Phelma-Promo-MT-2026/ZigBee/documentation/design/LNA/LNA_DashBoard_InducDeg.pptx

## LNA DASHBOARD 2.0

## To do list

- Transcient avec bonding → point de compression

## Step 1 - Extraction gm

MOS :
W = 106u
N = 0,130u

Vgs = 0,604V

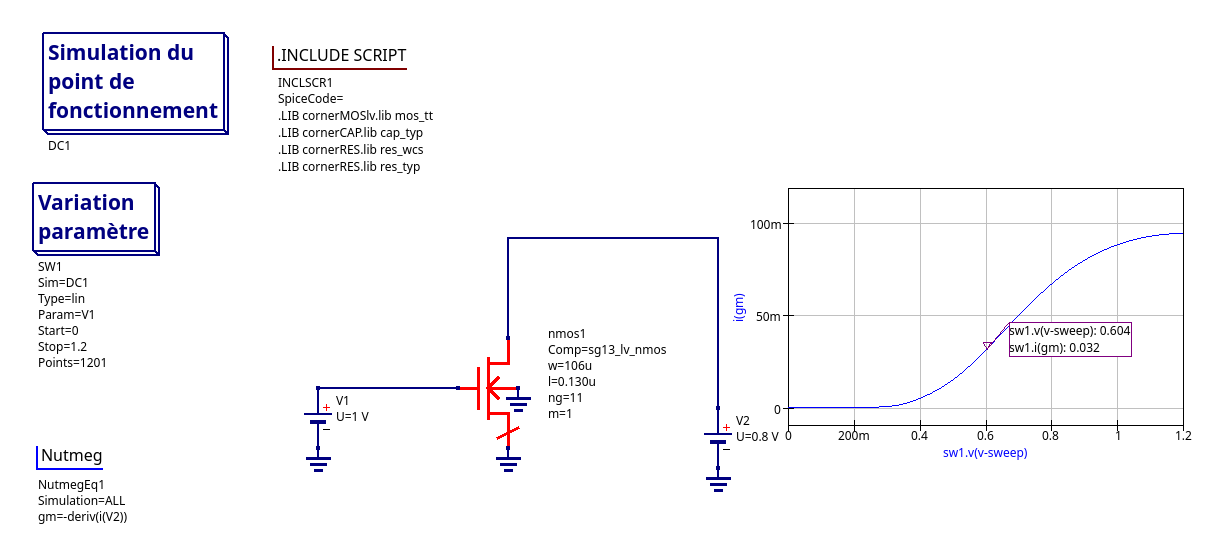
[picture p20: figure]

## Step 2 – Point de polarisation entrée

- MOS :
  - W = 106u
  - N = 0,130u
- Ll = 3nH
- C2 = 700fF
- L1 = 3nH
- Ls = 1,6nH
- Vgs = 0,656V
- Consommation :
- 4,49mA

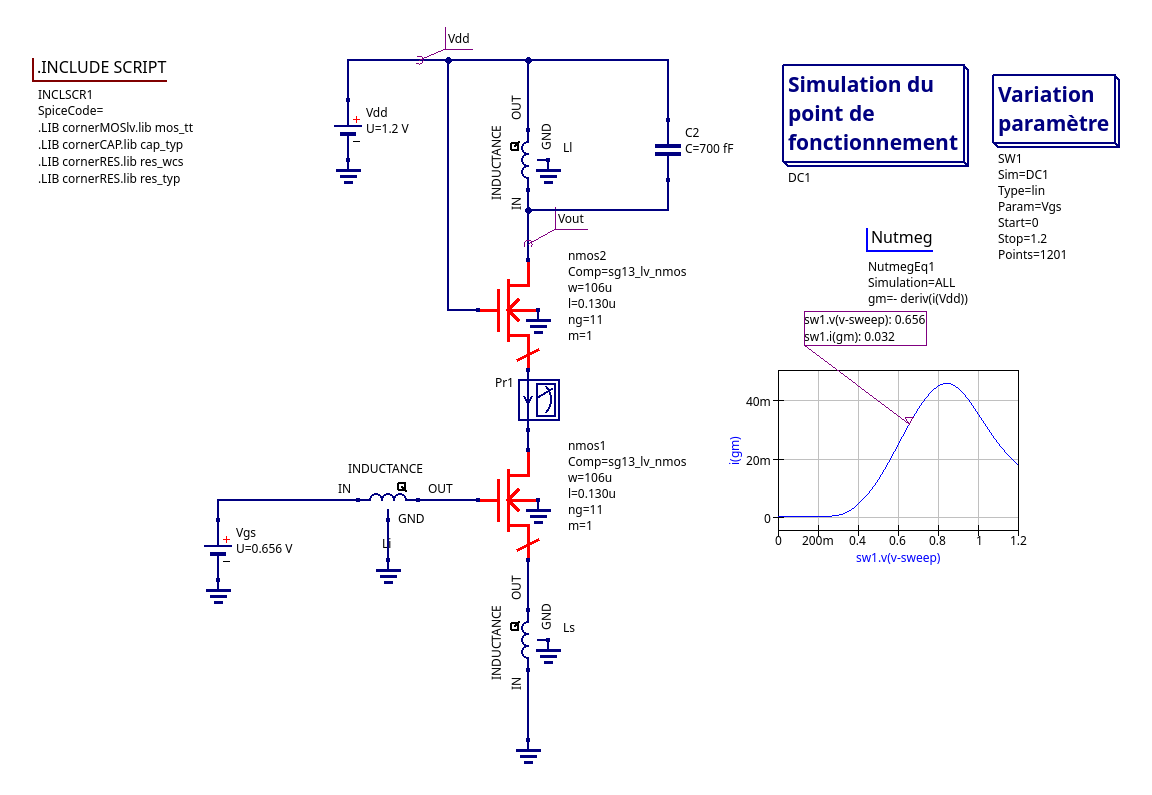
[picture p21: figure]

## Step 3 – adaptation entrée

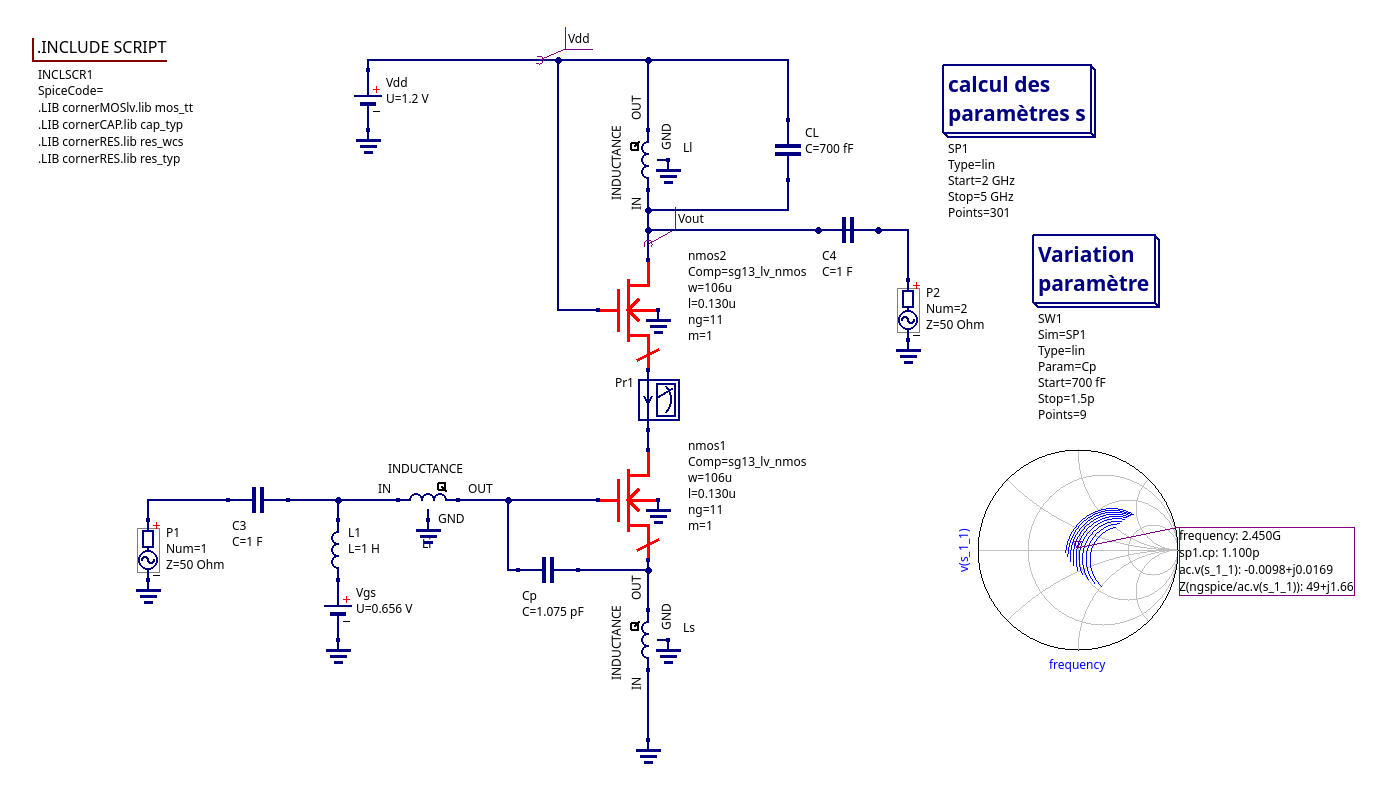
[picture p22: figure]

- Cp=C0=1,075pF
→ W = L = 26,5u

## Step 4 – Mirroir de courant 4.1 – Tune W & L pour 4,49mA dans la branche

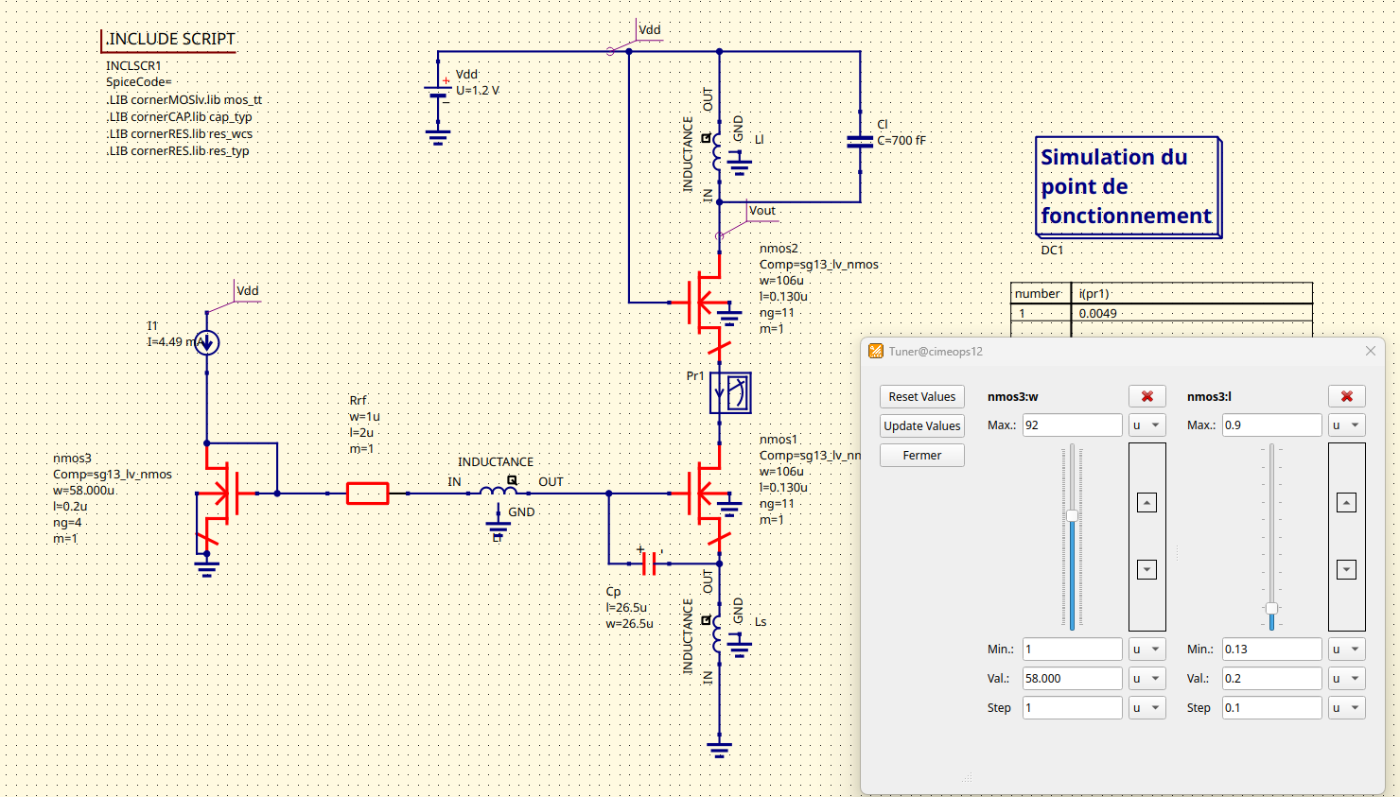
[picture p23: figure]

Rrf sert à empêcher le signal RF de venir sur le miroir
- Rrf = 5k Ohm
  - IHP Rhigh
    - W = 1um
    - L = 2um

NMOS 3
Ngate = 4
W = 58um
L = 200nm

## Step 4 – Mirroir de courant 4.1 – Rpol pour 4,5mA dans la branche

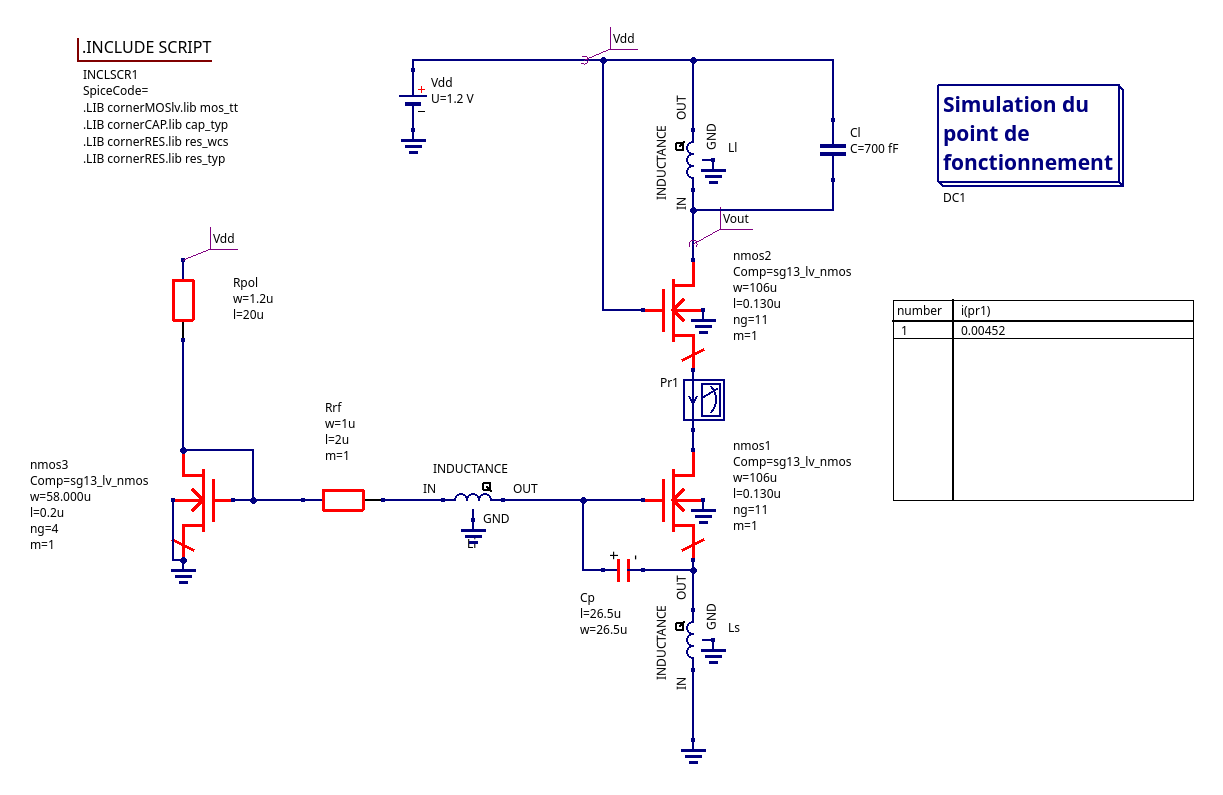
[picture p24: figure]

Rpol sert à polariser le miroir de courant. Par une analyse parametrique sur Rpol, on trouve Rpol = 130 ohm pour I = 4,5mA
En utilisant la resistance Rsil
W = 1,2um
L = 20um

## Step 5 - Gain

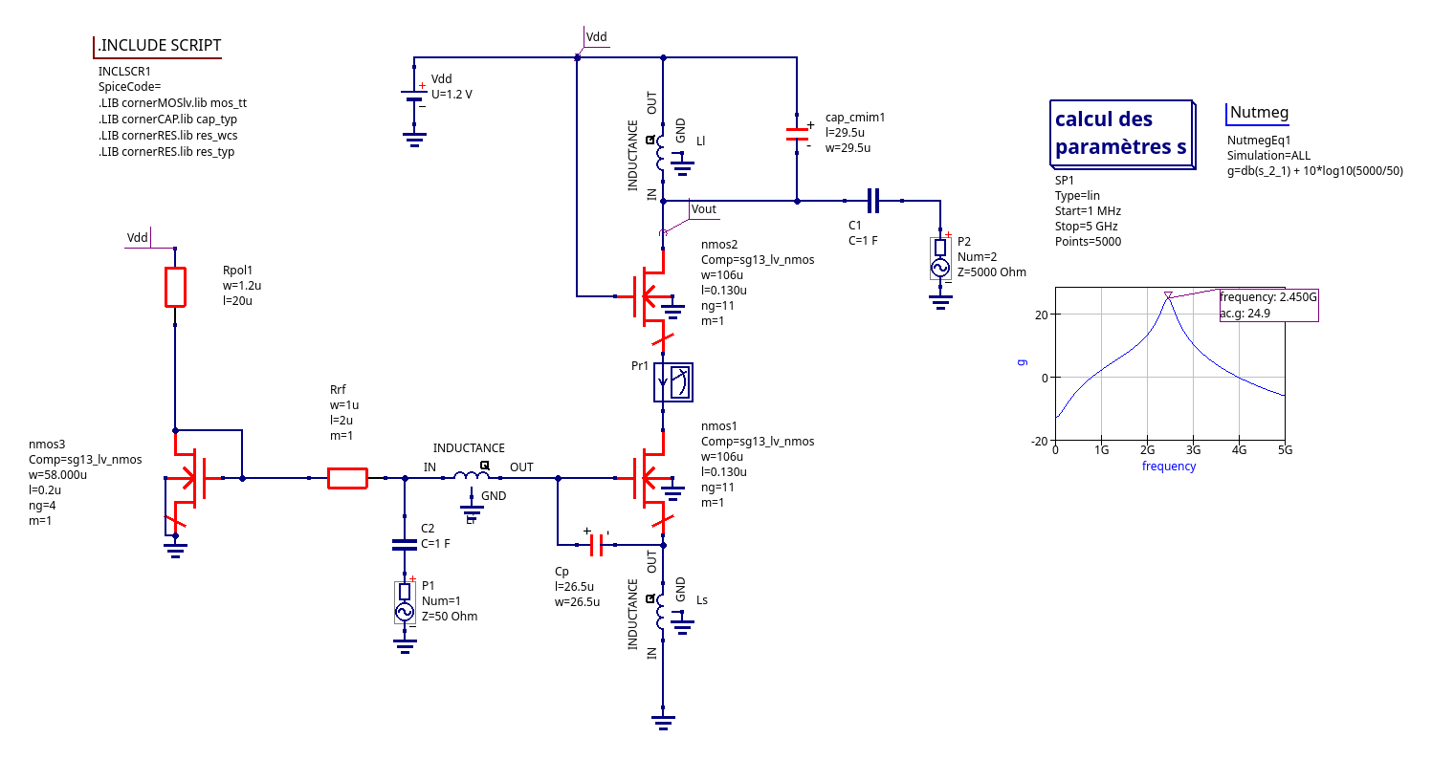
[picture p25: figure]

C resonnance = 1,3pF
Dimension W=L=29,5um
Gain = 24,9dB

## Step 6 – Adaptation sortie

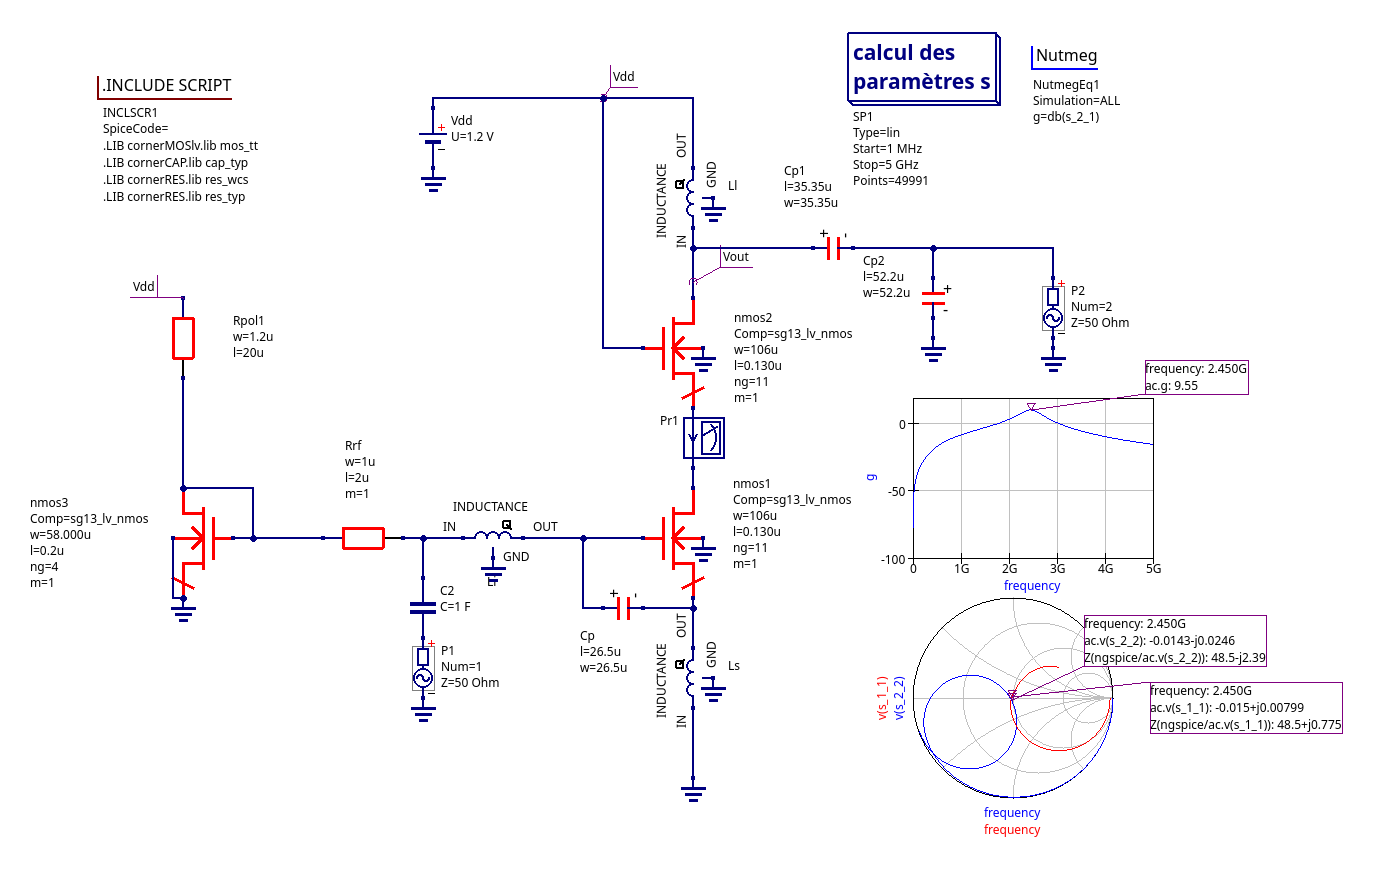
[picture p26: figure]

Zsortie = 48,5-j2,39
G = 9,55dB
Cp1 = 1,88pF
→W=L=35,35um
Cp2 = 4,1pF
→ W=L=52,2um

## RE-ADAPTER EN PRENANT EN COMPTE LES BONDING ET CAPA PLOT

## SYMBOLE

## LNA SYMBOL FINAL

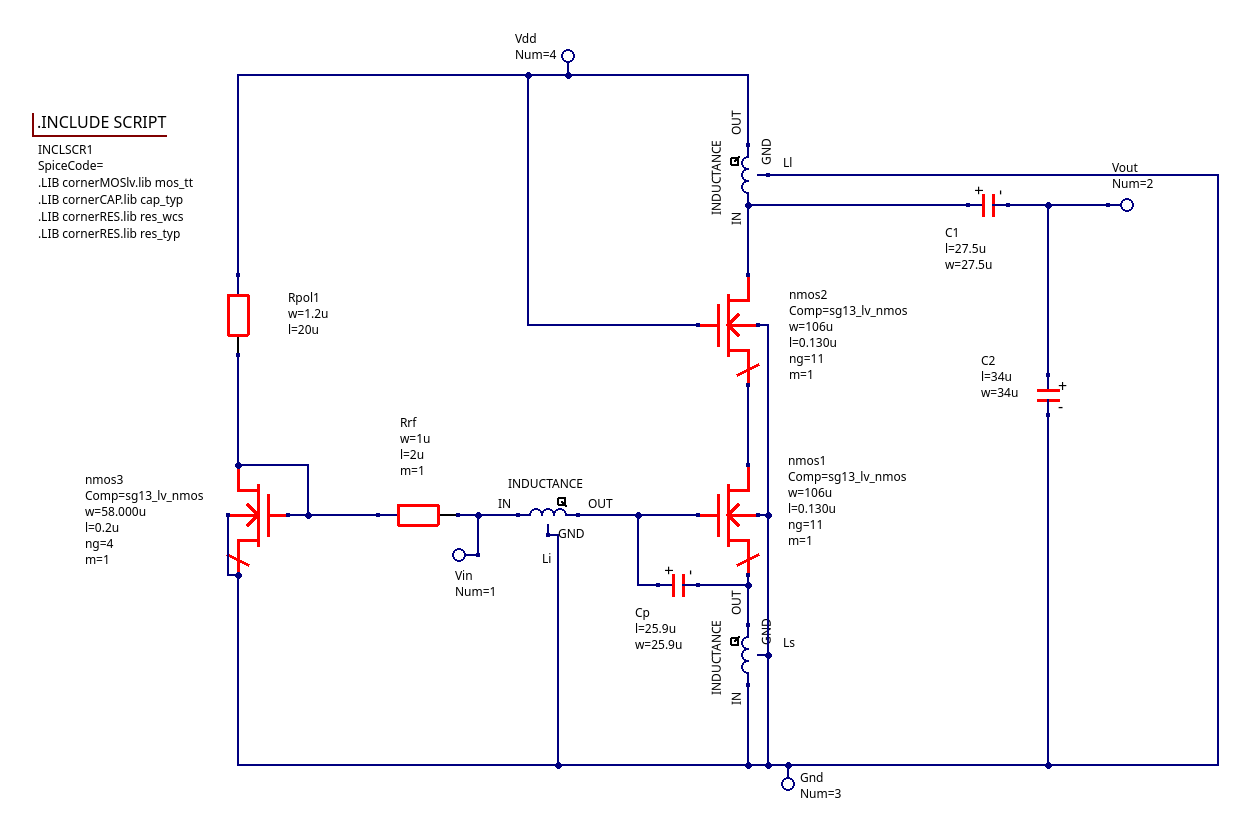
[picture p27: figure]

Composant | Valeur | Unité
Rpol(IHP Rsil) | 130 (W=1,2µm / L = 20µm) | Ω
Rrf (IHP Rhigh) | 5k (W=1µm / L = 2µm) | kΩ
Li | 3 | nH
Ls | 1,6 | nH
Ll | 3 | nH
Cp | 1,01 (W=L=25,9µm) | pF
C1 | 1,14 (W=L=27,5µm) | pF
C2 | 1,74 (W=L=34µm) | pF
Nmos1 | W=106µm / L=0,13µm / Ng= 11 | -
Nmos2 | W=106µm / L=0,13µm / Ng= 11 | -
Nmos3 | W=58µm / L=0,2µm / Ng = 4 | -

## BENCH FINAUX

- PARAMETRES S

## LNA ADAPTE + BONDING Parametre S

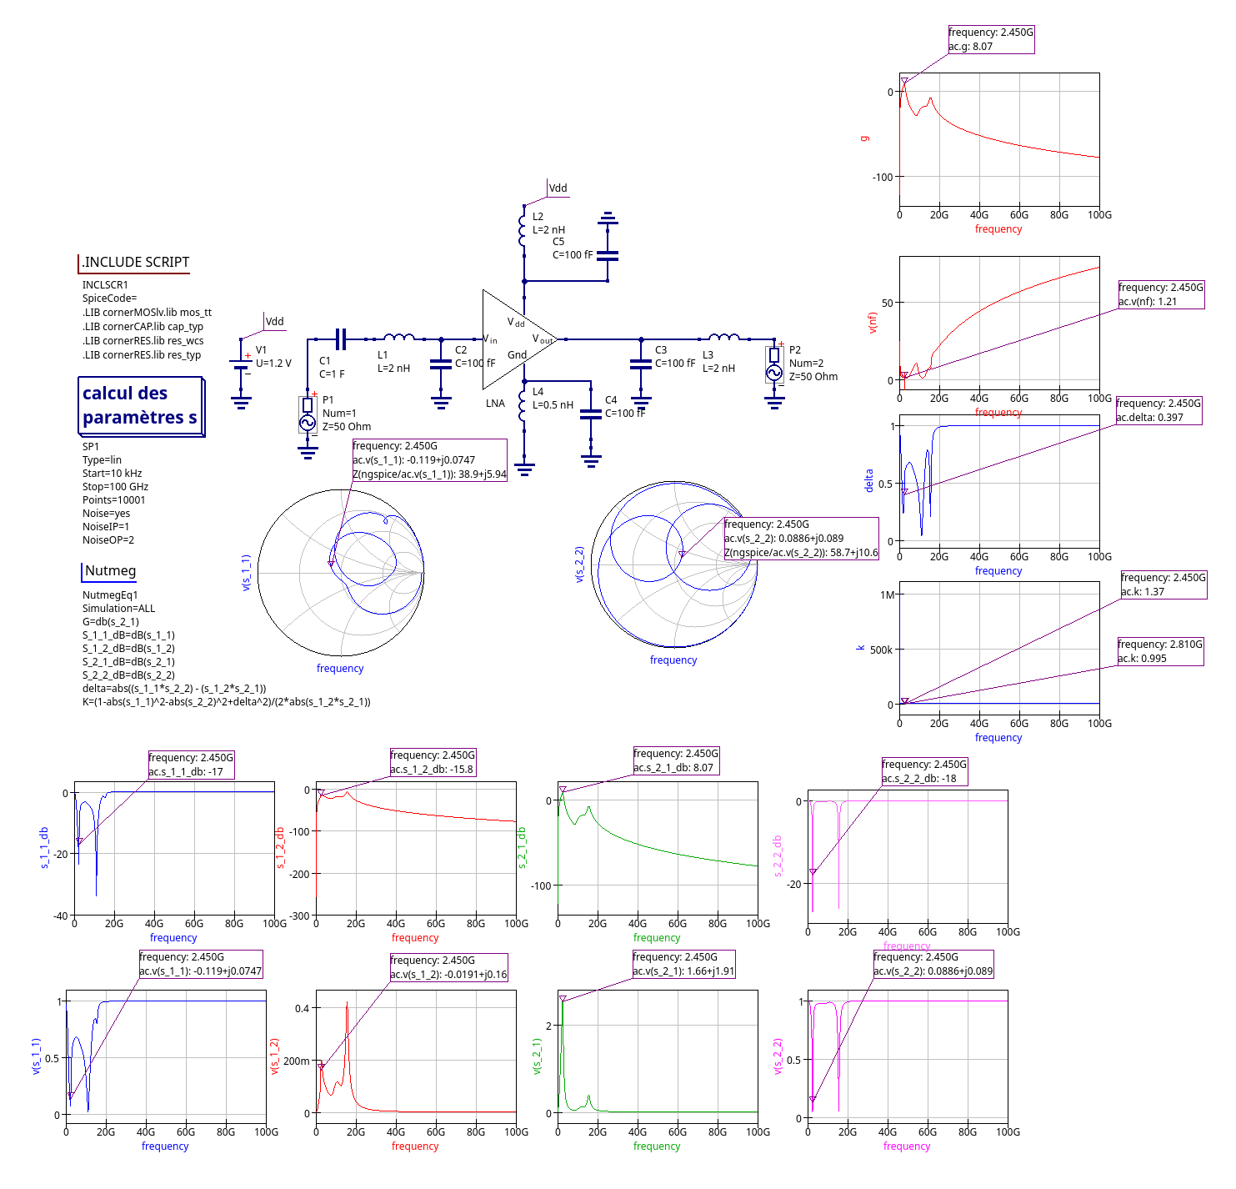
[picture p28: figure]

A 2,45 GHz
- Gain = 8,07dB
- S11 = -17dB
- S22 = -18dB
- Delta = 0,397 <1
- K = 1,37 >1
- NF = 10*log10(1,21) = 0,82dB ??
Instabilité à partir de f = 2,8GHz
→ K<1

## LNA ADAPTE + BONDING Simulation transitoire
