Phelma-Promo-MT-2026/ZigBee/documentation/Spec_projet/Presentation Calcul Specifications.pptx

## Etudes Préliminaires

Promo MT 2026

## Agenda

1

Calculs Spécifications

Paramètres techno

Paramètres design

2

3

## Calculs spécifications

1

Objectifs :
→ Explications, calculs et de valeurs des spécifications du récepteur
- Récepteur global :
  - Facteur de bruit + Gain
  - Sensibilité (PSi,min) => Distance maximale
  - Non-linéarité (IIP3) => PSi,max => Distance minimale

## Gain / Facteur de bruit récepteur (LNA + Mixers)

- NF + Gain par bloc :
  - LNA => Déterminé avec S.BOURDEL
  - Mixers => Etat de l'art
- NF + Gain Récepteur :
  - Calculé => Validé par S.BOURDEL
  - NF :
- Vin : tension d’entrée du bloc
  - LNA --> V_(IN) =√(2∙P_(Si,min) ∙R) avec R=50Ω
  - Mixer --> V_(IN) =√(2∙P_(Si,min) ∙R) ∙G_(LNA)

## Sensibilité / IIP3 récepteur

- Puissance de l’émetteur :
  - Donnée par le cahier des charges
- Sensibilité = Psi,min :
  - Puissance de réception minimale du récepteur => Distance max
  - P_(Si,min) =NF−174+10log_10 ∆f+SNR_(req)
- Psi,max :
  - Puissance réception maximale du récepteur => Distance min
  - P_(Si,max) =(2∙IIP3+P_(NFi))/3
- FM :
  - Marge sur les pertes dans un environnement intérieur
- Atténuation :
  - Causée par la distance entre l’émetteur et le récepteur
  - Att=P_E −P_R −FM
- Distance
  - d=(λ∙10^((Att)/20))/(4π)

- IIP3 :
  - LNA & MIXER : Discussion S. BOURDEL
  - De telle sorte à avoir un IIP3 du récepteur proche de celui du LNA

PNFi

## PLL

- Cahier des charges :
  - MP à 30° peut être à tester

Propositions validées par S.BOURDEL (à tester) :
Gain VCO => Plage de fréquence : 90 MHz/V
Courant => Plage de courant : 100 µA
Résultat calculs :
C1=(ωz)/(ω_p)∗1/(ω_c^2)∗(Ko)/n∗(Io)/(2∗π)∗(√(1+((ω_c)/(ω_z))^2))/(√(1+((ω_c)/(ω_p))^2))
C2=C1 ∗((ω_p)/(ω_z −1))
R=1/(C2∗ω_z)

Valeurs réalisables du filtre

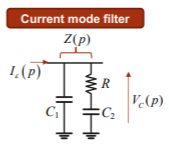
[picture p33: figure]

Paramètres :
ω_c = 2∗π∗fc
ωp= (ω_c)/(1/(cos(MP))−tan(MP))
ωz= (ω_c^2)/(ωp)

## Paramètre techno

2

  - Etat de l'art / Recherche sur internet :
https://ihp-open-pdk-docs.readthedocs.io/en/latest/contents.html
  - Calcul de Cox Formule :
  - Calcul de Kn Formule :
  - Calcul de VDsat Formule :
  - Calcul de Gm Formule :

## Slide 8
