Phelma-Promo-MT-2026/ZigBee/documentation/design/PLL/PDC.pptx

## Slide 2

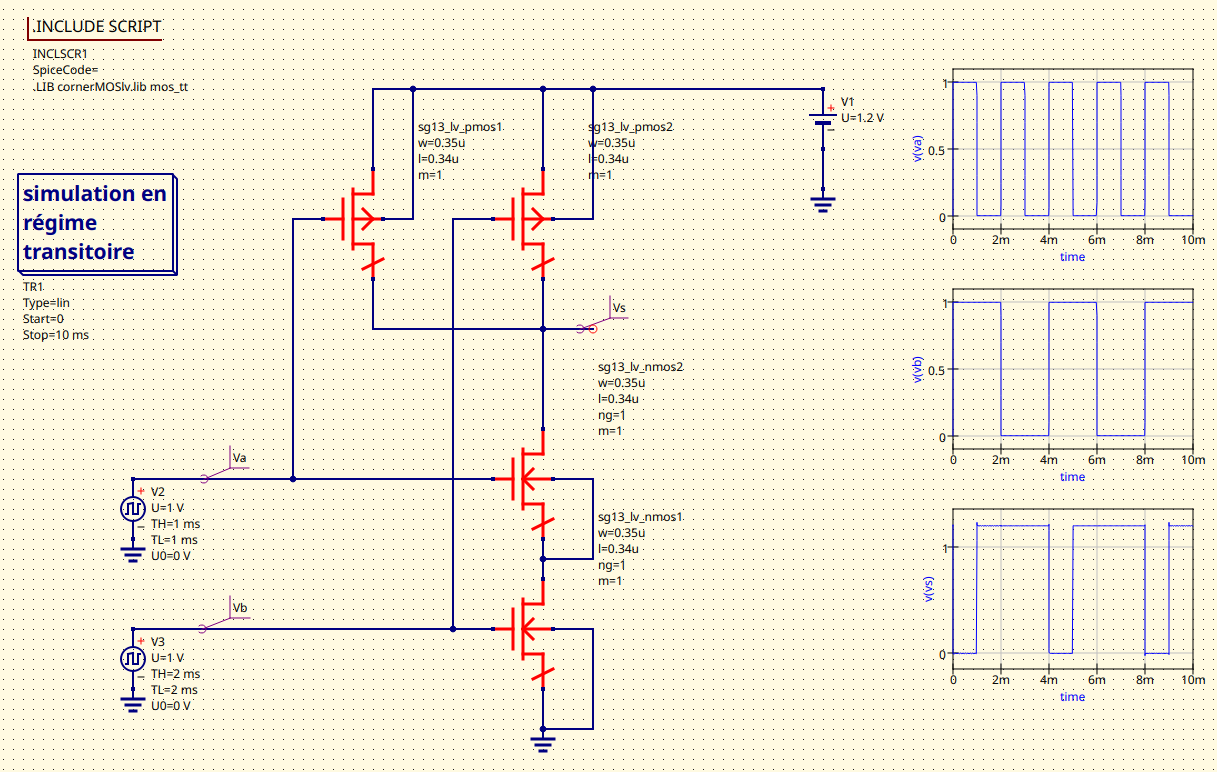
[picture p34: figure]

## Slide 3

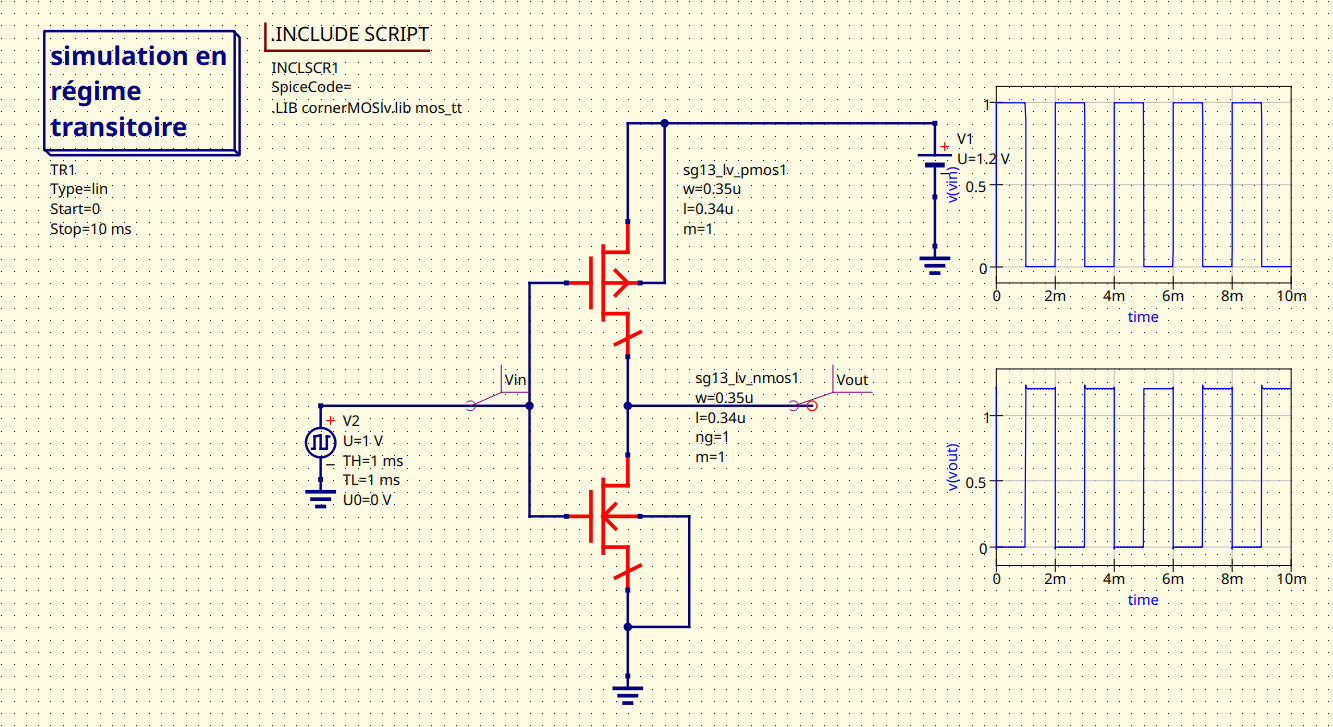
[picture p35: figure]
