Phelma-Promo-MT-2026/ZigBee/documentation/Tutoriels/TUTO_Depot_GitHub.pptx

## GitHub – installation et usages

IHP – Open PDK

Sacha lutoff | colin bariller

## Agenda

1

2

3

4

Introduction a GitHub

Installer le dépôt sur sa VMs

Travailler avec Git

Documentation

## GitHub – Qu’est-ce que c’est?

- Une plateforme d'hébergement de fichier basée sur Git
- Idéal pour le développement en équipe et le versioning
  - Suivi des modifications
  - Travail collaboratif
  - Revenir à des versions précédentes
  - Fusionner différentes contributions

## Fonctionnement de GitHub

1. Cloner un dépôt sur votre machine
2. Travailler en local (modifier, ajouter des fichiers)
3. Faire des commits (enregistre les modifications en locale)
4. Pousser les modifications sur GitHub

## Notion de branche

- Une branche est une version parallèle du projet
- Permet de développer sans impacter la branche principale (`main`)
- Chaque nouvelle fonctionnalité peut être développée dans une branche séparée

## Les différentes branches

MAIN

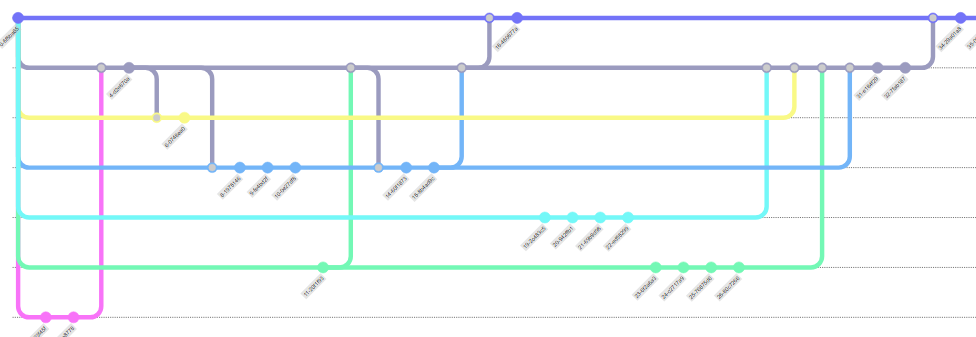
[picture p59: figure]

Dev

LNA_1

LNA_2

Mixer

PLL

Self

## Règles d’usage

- Toujours travailler sur une branche dédiée
- Faire des commits clairs et fréquents
- Ne pas modifier `main` ou `dev` directement
- Faire relire les Pull Requests avant fusion

## Installer le dépôt sur sa VM Début sur GitHub

1. Créer un compte sur GitHub https://github.com (https://github.com/notifications)
2. Transmettre votre pseudo GitHub en fin de diapo
3. Attendre d’être ajouté comme collaborateur
  - Action par admin (Sacha.L)
4. Accepte l'invitation via : https://github.com/notifications

## Installer le dépôt sur sa VM Notion de token

- Un Token est une clé d'authentification sécurisée utilisée pour interagir avec GitHub.
- Remplace l'utilisation du mot de passe dans Git.
- Permet d’automatiser et sécuriser les accès au dépôt GitHub.
- Doit être généré sur GitHub et stocké en local pour éviter de le saisir à chaque push.

Clone / pull


push

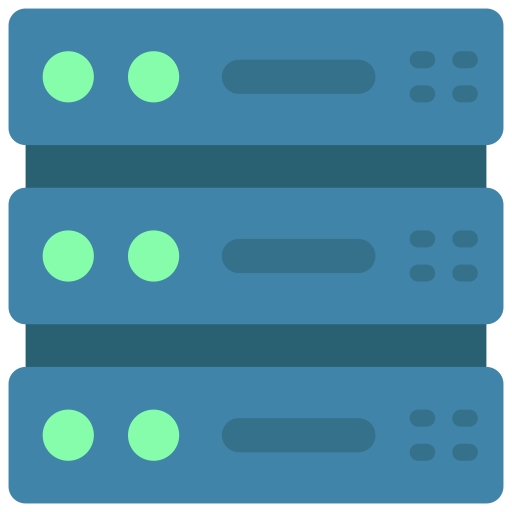
[picture p60: figure]

## Installer le dépôt sur sa VM Notion de token

- Un Token est une clé d'authentification sécurisée utilisée pour interagir avec GitHub.
- Remplace l'utilisation du mot de passe dans Git.
- Permet d’automatiser et sécuriser les accès au dépôt GitHub.
- Doit être généré sur GitHub et stocké en local pour éviter de le saisir à chaque push.

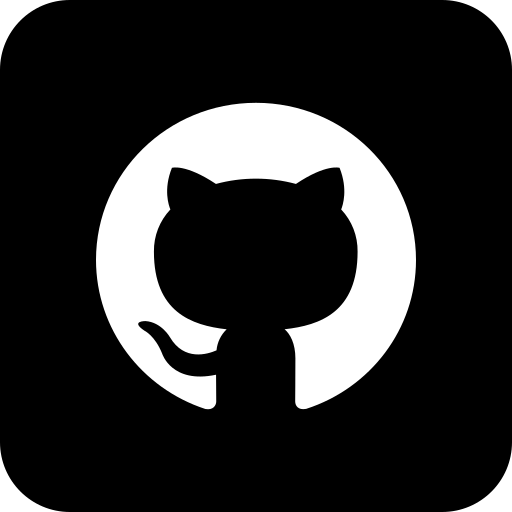
[picture p61: figure]

Token

push

Clone / pull

## Installer le dépôt sur sa VM Générer un Token GitHub

1. Aller sur : GitHub | (https://github.com/settings/tokens)Token (https://github.com/settings/tokens)
2. Générer un 'Personal Access Token (classic)'

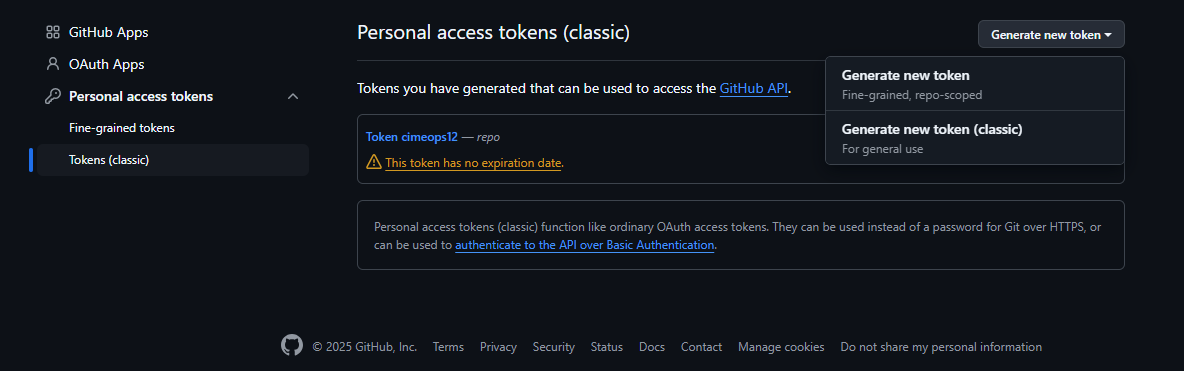
[picture p62: figure]

## Installer le dépôt sur sa VM Générer un Token GitHub

3. Rentrer un nom (numéro de votre VMs par exemple)
4. Selection une date d’expiration (pas d’expiration)
5. Coche 'repo' pour autoriser Git

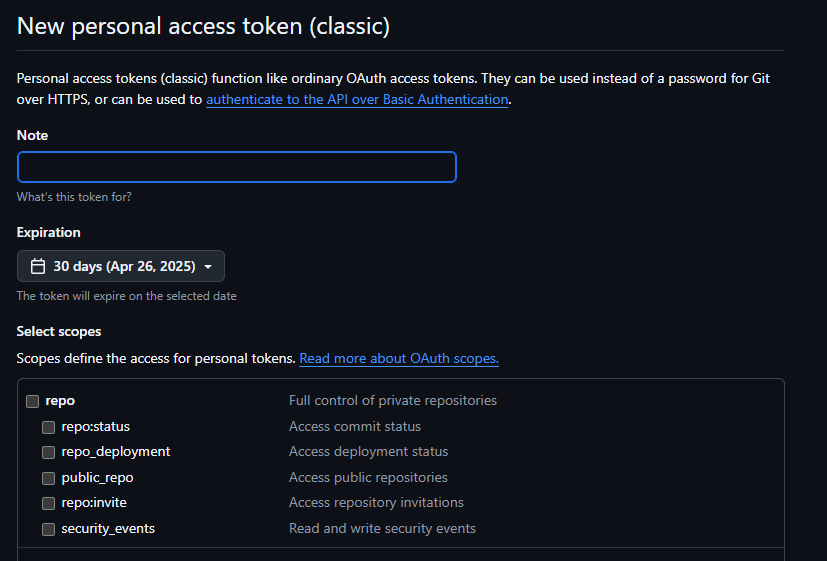
[picture p63: figure]

## Installer le dépôt sur sa VM Générer un Token GitHub

5. Copier et enregistrer le token immédiatement
ATTENTION : LE TOKEN N’EST VISIBLE QU’A SA CREATION, ENREGISTREZ LE DANS UN .txt SI VOUS N’ETES PAS SUR DE VOS MANIP

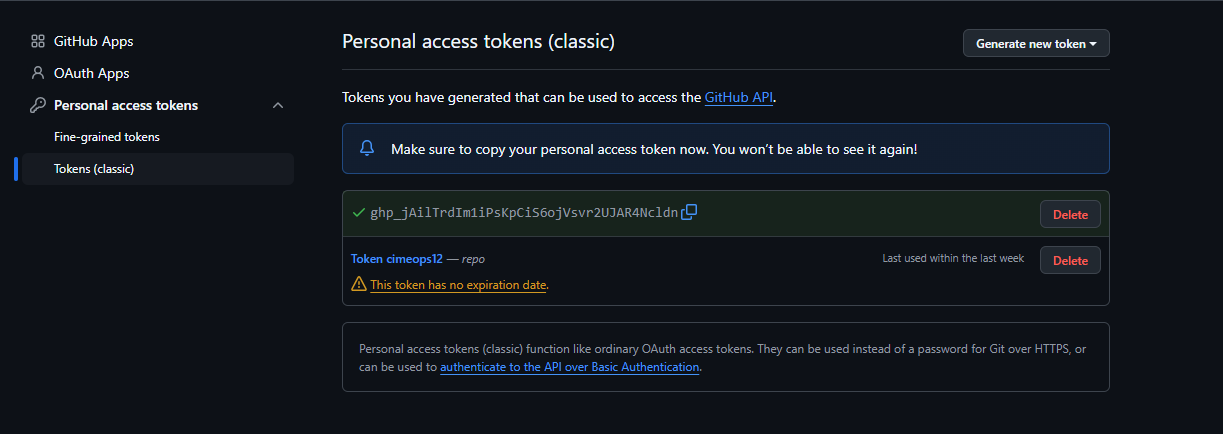
[picture p64: figure]

## Travailler avec Git ~/microelectronics/projets/ZigBee Manipuler les branches

- Créer une branche de travaille :
- Mettre à jour votre branche :
- Changer de branche de travaille :
- Mettre à jours les branches disponible

$git checkout –b Ma-Branche

$git pull origin Ma-Branche

$git checkout Mon-autre-Branche

$git fetch origin

## Installer le dépôt sur sa VM Enregistrer le token dans votre VM

1. Activer la sauvegarde du token
2. Cloner le dépôt
3. Entrer le token à la place du mot de passe (1 seule fois)

$cd ~/microelectronics/projects
$git config --global credential.helper store
$git clone https://github.com/TolacShaffu/ZigBee.git
$Rentrer votre nom d’utilisateur Github
$Rentrer votre copié token

## Travailler avec Git ~/microelectronics/projets/ZigBee Pousser une version dans ma branche

1. Vérifier que je suis bien dans ma branche:
2. Ajouter et commit :
3. Pousser la branche :

$git add . //ajoute tous les documents nouveau
$git commit –m «commentaire»

$git push origin Ma-branche

$git checkout Ma-branche

## Créer une Pull Request fusion d’une branche avec une autre

1. Aller sur GitHub : https://github.com/TolacShaffu/ZigBee.git/pulls (https://github.com/TolacShaffu/ZigBee.git/pulls)
2. Cliquer sur 'New Pull Request'
3. Sélectionner ta branche
4. Soumettre la PR pour validation

## Mettre à Jour le Dépôt après la pull request d’un collaborateur

1. Revenir sur la branche principale :
2. Récupérer les dernières mises à jour :
3. Fusionner avec ta branche :

$git checkout main //or dev

$git pull origin main

$git checkout LNA
$git merge main

## Pseudo GitHub

Prénom / nom | Pseudo Git | Branche dédié
Michel Amigo | Amigom-MT | PLL
Sofian Archambault | | PLL
Elyas Arfaoui | ElyasPuffu | Mixer
Akram Atouile | akrxm2a | LNA_grille_com
Colin Bariller | Coco2238 | PLL
Fatou Fall | fatoufall296 | Mixer
Brice Gogué-Meunier | Xiramins | LNA_grille_com
Timothée Grunwald | timgrunewald | PLL
Sarah Hadi | hadisarah75 | Mixer
Sacha Lutoff | TolacShaffu | LNA_ind_deg
Baptiste Monget | BaptisteMonget | LNA_1 - Inductance

## Pousser son projet dans le main Structure du dossier

Zigbee/nom_bloc/
|→etapes_ dimensionnement/
|_vos différents bench de dimensionnement pour une traçabilité
| → dimensionnement/
|_ Nom_bloc_xschem.sch
|_ Nom_bloc.spice
|_ Nom_bloc_sym_qucs.sch
|_ Nom_bloc_bench_simu_qucs.sch
| → layout/
|_ .gds

## Pousser son projet dans le main Commandes

git checkout main
git pull origin main
git checkout my_branch -- etapes_ dimensionnement dimensionnement layout
git add dimensionnement layout
git commit -m "Ajout des dossiers etapes_dimensionnement dimensionnement et layout depuis my_branch"
git push origin main

## Documentation

- Depot git : https://github.com/TolacShaffu/ZigBee
- Documentation github : https://docs.github.com/fr
