Phelma-Promo-MT-2026/ZigBee/documentation/Spec_techno/Paramètres techno.xlsx

Datasheet Nmos | μn (cm²/V.s) | Eps0(F/m) | EpsR(F/m) | Tox(nm) | W(m) | L(m) | VT(V) | VDD(V) | IdSat(A)
 | 310 | 8.854e-12 | 3.49733e-11 | 2.45 | 1e-05 | 1.3e-07 | 0.5 | 1.2 | 0.0048
Calcul de Cox | Cox(F/m²) | Cox(fF/μm²)
 | 0.01427481633 | 14.27
Calcul de Kn | Kn(A/V²) | Kn(uA/V²)
 | 0.0002212596531 | 221.26
Pour W=10e-6, on calcule les valeurs en dessous (W peut varier-->dimensionnement bloc)
Calcul de Vdsat | VDsat(V)
 | 0.53
Calcul de Gm | Gm(A/V)
 | 0.01807715375
Calcul de Capa | Cgs/Cgd(F) | Cgs/Cgd(fF) | CMiller(fF/um) | CJunction(fF/um²)
 | 9.278630612e-15 | 9.278630612 | 0.36 | 0.95
Datasheet Pmos | μp (cm²/V.s) | Eps0(F/m) | EpsR(F/m) | Tox(nm) | W(m) | L(m) | VT(V) | VDD(V) | IdSat(A)
 | 200 | 8.854e-12 | 3.49733e-11 | 2.45 | 1e-05 | 1.3e-07 | 0.47 | 1.2 | 0.00215
Calcul de Cox | Cox(F/m²) | Cox(fF/μm²)
 | 0.01427481633 | 14.27
Calcul de Kp | Kp(A/V²) | Kp(uA/V²)
 | 0.0001427481633 | 142.75
Calcul de Vdsat | VDsat(V)
 | 0.44
Calcul de Gm | Gm(A/V)
 | 0.01
Calcul de Capa | Cgs/Cgd(F) | Cgs/Cgd(fF) | CMiller(fF/um) | CJunction(fF/um²)
 | 9.278630612e-15 | 9.28 | 0.36 | 0.95
