Phelma-Promo-MT-2026/ZigBee/documentation/Spec_projet/Specifications.xlsx

Sheet: Spec_Systeme
SENSIBILITE ET IIP3 DU RECEPTEUR ZIGBEE
GAIN ET FACTEUR DE BRUIT DU RECEPTEUR ZIGBEE
Element | NF | NF (dB) | Gain linéaire en puissance | Gain (dB)
LNA | 3.2 | 5.0 | 100.0 | 20.0 |  |  |  | 8.0
mélangeur | 4.0 | 6.0 | 0.4 | -4.0
filtre IF | 1.0 | 0.0 | 1.0 | 0.0
NF (formule de FRIIS en LINEAIRE) | 3.2
NF FRIIS (dB) | 5.0
Gain récepteur (dB) | 16.0
SENSIBILITE DU RECEPTEUR ZIGBEE
SNR requis (dB) | 14.0
thermal noise(dBm/Hz) | -174.0
bandwidth | 3000000.0
Sensibilité (dBm) | -90.2
NON-LINEARITE DU RECEPTEUR ZIGBEE
Element | IIP3 (dBm) | IIP3 (mW) | OIP3 (dBm) | OIP3 (mW) | Gain (linéaire en puissance) | Gain (dB)
LNA | 13.0 | 20.0 | 33.0 | 1995.262 | 100.0 | 20.0
mélangeur | 26.0 | 398.1 | 22.0 | 158.489 | 0.4 | -4.0
IIP3 récepteur (mW) | 3.3
OIP3 récepteur (mW) | 132.1
IIP3 récepteur (dBm) | 5.2
OIP3 récepteur (dBm) | 21.2099
Puissance de bruit en sortie du récepteur (dBm) dans 1 Hz | -153.0
SFDR (dB) | 116.1
 |  |  | atténuation (dB) | c (m/s) | f (Hz) | n | FM
 |  |  | 110 | 300000000 | 2445000000 | 3.0 | 30.0
 |  |  | Free Space
 |  |  | dmax (m) | dmin (m)
 |  |  | 3087.7
 |  |  | One Slope
 |  |  | dmax (m)
 |  |  | 212.0418989
 |  |  | 97.64106938
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
