Phelma-Promo-MT-2026/ZigBee/documentation/design/PLL/Travail1_PLL(Feuil1).xlsx

Paramètres fixes |  |  |  |  |  |  |  |  | Gain fixe à 90 MHz/V ; courant variable |  |  |  |  |  | Courant fixe à 1mA ; gain variable (pas utile car on ne peut pas faire varirer le gain)
MP (°) | MP (rad) | Column1 |  |  | Gain VCO[MHz/V] | Ko/N |  | Courant I0 | C1 | C2 | R |  |  |  | C1 | C2 | R
60 | 1.05 |  |  |  | 80000000 | 312500 |  | 1e-05 | 8.844314151e-14 | 1.143410908e-12 | 1038951.666 |  |  |  | 1.35027697e-13 | 1.745665508e-12 | 680513.3413
 |  |  |  |  | 81000000 | 316406.25 |  | 2e-05 | 1.76886283e-13 | 2.286821816e-12 | 519475.8331 |  |  |  | 1.367155432e-13 | 1.767486327e-12 | 672111.9421
Fquartz [Hz] | 10000000 |  |  |  | 82000000 | 320312.5 |  | 3e-05 | 2.653294245e-13 | 3.430232723e-12 | 346317.2221 |  |  |  | 1.384033894e-13 | 1.789307146e-12 | 663915.455
Fc[Hz] | 500000 | ratio de 20 |  |  | 83000000 | 324218.75 |  | 4e-05 | 3.537725661e-13 | 4.573643631e-12 | 259737.9165 |  |  |  | 1.400912356e-13 | 1.811127965e-12 | 655916.4736
 |  |  |  |  | 84000000 | 328125 |  | 5e-05 | 4.422157076e-13 | 5.717054539e-12 | 207790.3332 |  |  |  | 1.417790818e-13 | 1.832948784e-12 | 648107.9441
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
