Phelma-Promo-MT-2026/ZigBee/documentation/design/Mixer/Dimensionnement_mixeur.xlsx

Sheet: Cellule de GIlbert
FOL(Hz) | 2440000000
FIF(Hz) | 10000000
FRF(Hz) | 2450000000
VOL(V) | 2
VDD(V) | 1.2
VRF(V) | 0.4
VIF(V) | 0.7
IIP3(dBm) | 15
RL(Ohms) | 800
CL(fF) | 200
Gv(dB) | 8 |  |  |  | gm(N1,N2) (A/V) | 0.004932077475 | 0.030772636
Gv | 2.51 |  |  |  | gm(N3,N4,N5,N6) (A/V) | A déterminer
NF(dB) | 11.2
1ère étape: calcul de Ip
 | alpha | Ip(A) |  |  |  |  |  | FRF(GHz) | 2.45
 | 2.65 | 0.004635680601 |  |  |  |  |  | FOL(GHz) | 2.44
2éme étape: tension mode commun |  |  |  |  |  |  |  | VOL(V) | 2
 | VRFMC(V) | VRFMC (V) adapté | VOLMC(V) | VOLMC (V) ADAPTÉ |  |  |  | VDD(V) | 1.2
 | 0.48 | 1.1 | 0.8 | 2.64 |  |  |  | VRF(V) | 0.4
3éme étape: calcul de W(N1) et W(N2) |  |  |  |  |  |  |  | RL(Ohms) | 800
4éme étape: calcule de W(N3) , W(N4), W(N5) et W(N6)
 | L(N1) (m) | 1.3e-07
 | W(N1,N2) (m) | 1.702294312e-05 |  |  |  |  |  | L(µm) | 0.13
 | W(N3,N4,N5,N6) (m) | 1.604575654e-05 |  |  |  |  |  | W(N1,N2) (µm) | 17
 | Idsat(N1,N2) (A) | 0.008171012696 |  |  |  |  |  | W(N3,N4,N5,N6) (µm) | 16
 | Idsat(N3,N4,N5,N6) (A) | 0.007701963141 |  |  |  |  |  | vgsRF(V) | 0.8
 | Vdsat(N1,N2) (V) | 0.53 |  |  |  |  |  | vgsOL(V) | 0.8
 | Vdsat(N3,N4,N5,N6) (V) | 0.53
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
