Phelma-Promo-MT-2026/ZigBee/documentation/design/Inductance/Dimensionnement_Inductance.xlsx

 |  |  |  | f=2,45GHz
N | W (µm) | S (µm) | Dint (µm) | L (nH) | Q (-) | Rsérie (Ω) | frésonnance (GHz) | Lrésonnance (nH)
4 | 5.5 | 2.1 | 182 | 6.94 | 7.69 | 14 | 6.0 | 39
3 | 4 | 2 | 70.7 | 1.12 | 3.53 | 4.94 | 26.6 | 7.42
3 | 15 | 5 | 150 | 4.9 | 15.1 | 4.63 | 9.6 | 38.5
4 | 10 | 5.5 | 182 | 6.01 | 13.2 | 7.07 | 8.1 | 49.1
2 | 12 | 3 | 200 | 1.67 | 10.8 | 2.4 | 20.4 | 21.7
3 | 15 | 3 | 180 | 4.18 | 14.4 | 4.51 | 8.9 | 32.3
3 | 4 | 2 | 150 | 3.02 | 6.56 | 7.16 | 12.3 | 22.7
3 | 10 | 2.1 | 163 | 3.02 | 11.7 | 4 | 10.95 | 25.2
3 | 10 | 2 | 170
