Phelma-Promo-MT-2026/ZigBee/developpement/Bench_composants_IHP/Images/Exemple_bench_capa.png

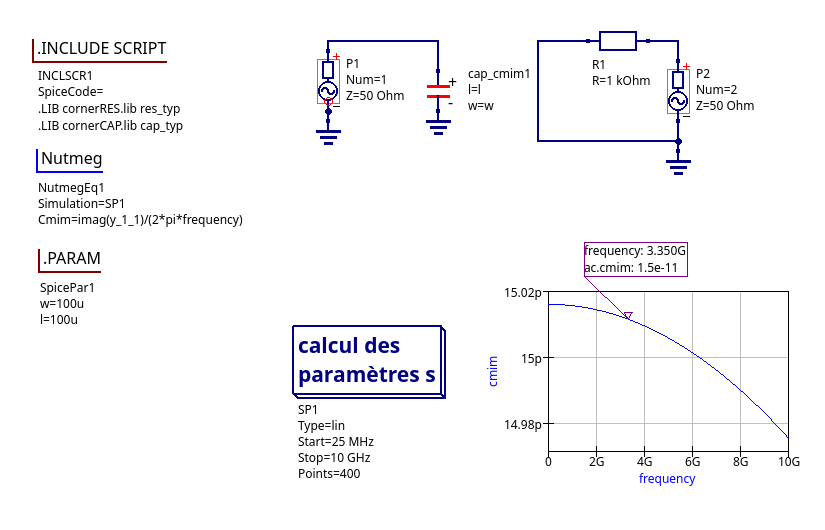
developpement/Bench_composants_IHP/Images/Exemple_bench_capa.png
