Phelma-Promo-MT-2026/ZigBee/developpement/Inductance/development/EM_simulation/Image/Ind_3nH.png

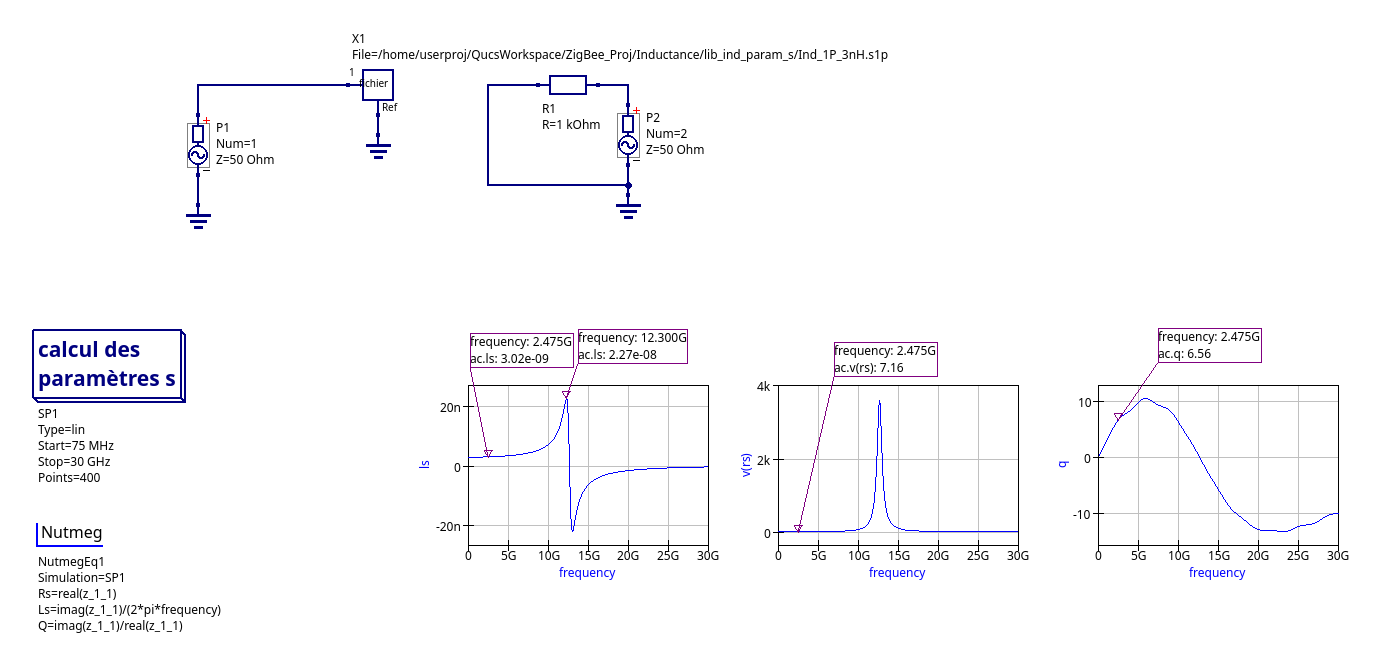
developpement/Inductance/development/EM_simulation/Image/Ind_3nH.png
