Phelma-Promo-MT-2026/ZigBee/developpement/Inductance/development/EM_simulation/Image/Ind_3nH_High_Q.png

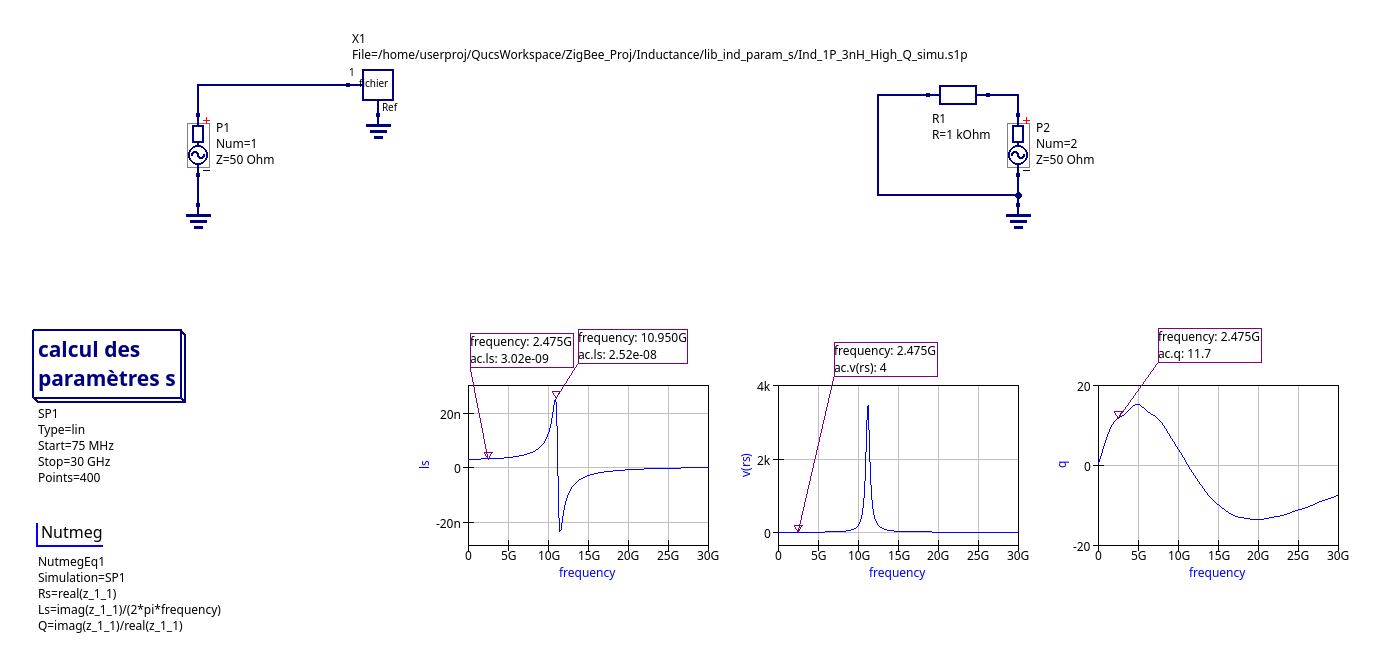
developpement/Inductance/development/EM_simulation/Image/Ind_3nH_High_Q.png
