Phelma-Promo-MT-2026/ZigBee/developpement/Inductance/development/EM_simulation/Image/modele_inductance_prof.png

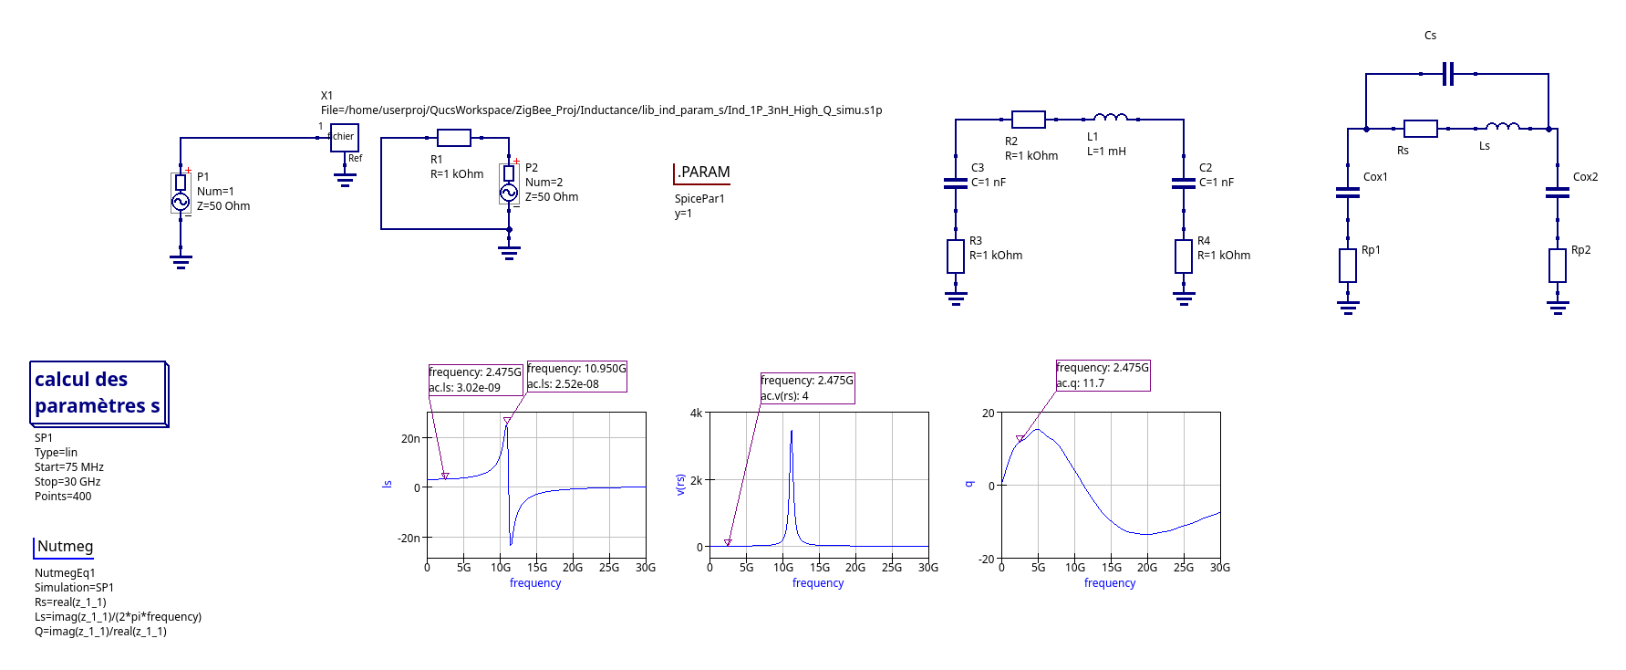
developpement/Inductance/development/EM_simulation/Image/modele_inductance_prof.png
