Phelma-Promo-MT-2026/ZigBee/developpement/Inductance/development/EM_simulation/Image/Simulation_6nH.png

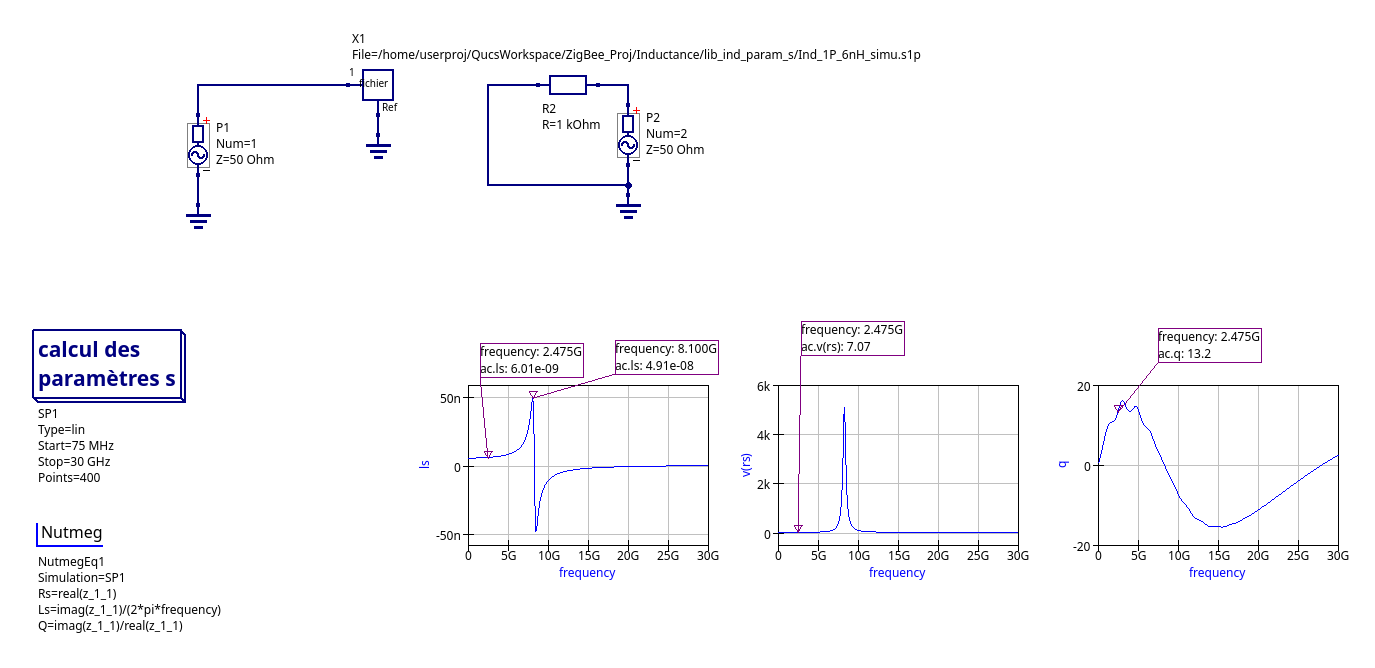
developpement/Inductance/development/EM_simulation/Image/Simulation_6nH.png
