Phelma-Promo-MT-2026/ZigBee/developpement/Inductance/development/EM_simulation/Image/Simulation_inductance_bench.png

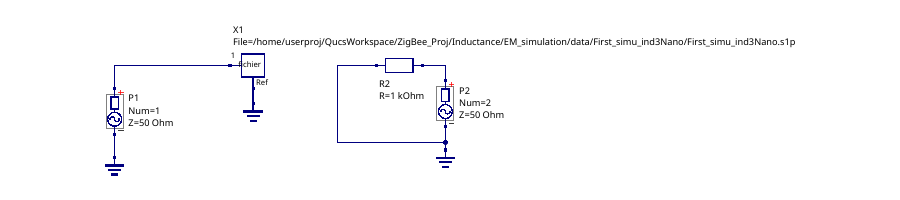
developpement/Inductance/development/EM_simulation/Image/Simulation_inductance_bench.png
