Phelma-Promo-MT-2026/ZigBee/developpement/LNA_grille_com/Xiramins/Screenshots/Layout diff zoom LNA.png

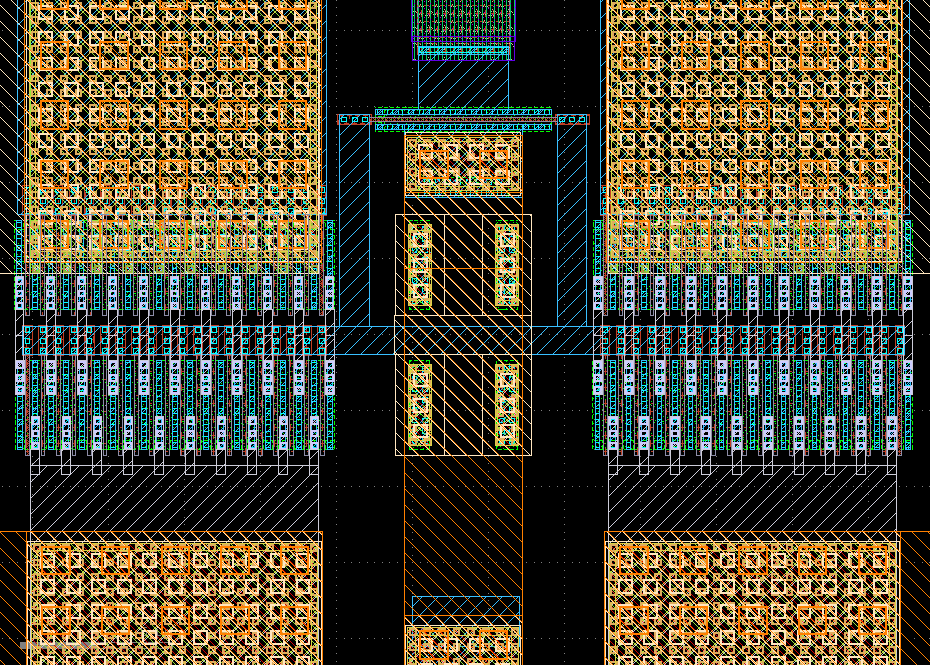
developpement/LNA_grille_com/Xiramins/Screenshots/Layout diff zoom LNA.png
