Phelma-Promo-MT-2026/ZigBee/developpement/LNA_grille_com/Xiramins/Screenshots/Layout single complet gnd cache.png

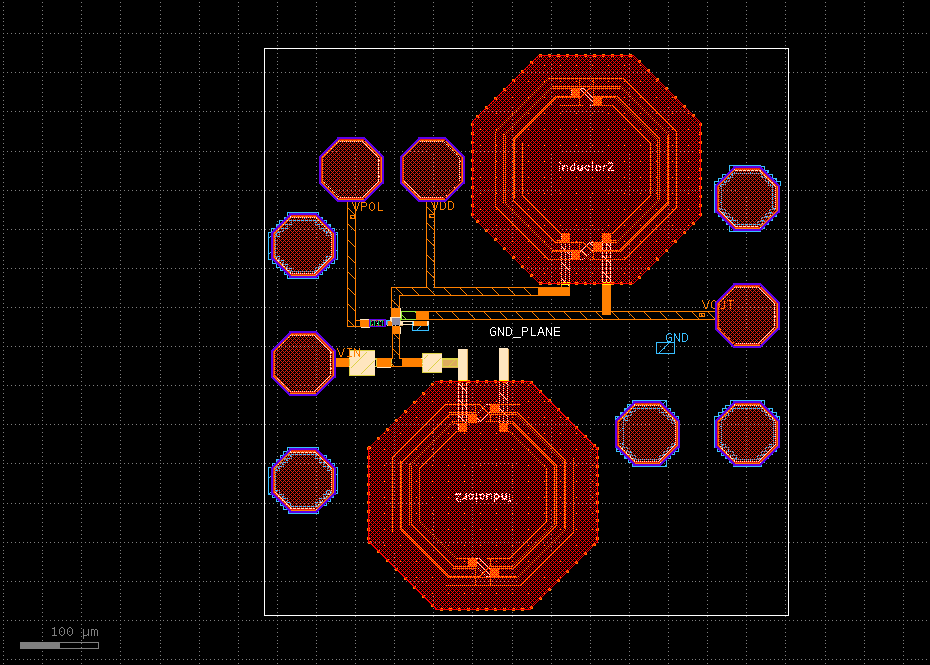
developpement/LNA_grille_com/Xiramins/Screenshots/Layout single complet gnd cache.png
