Phelma-Promo-MT-2026/ZigBee/developpement/LNA_Ind_degen/image/LNA_Bench_Parametre_S.png

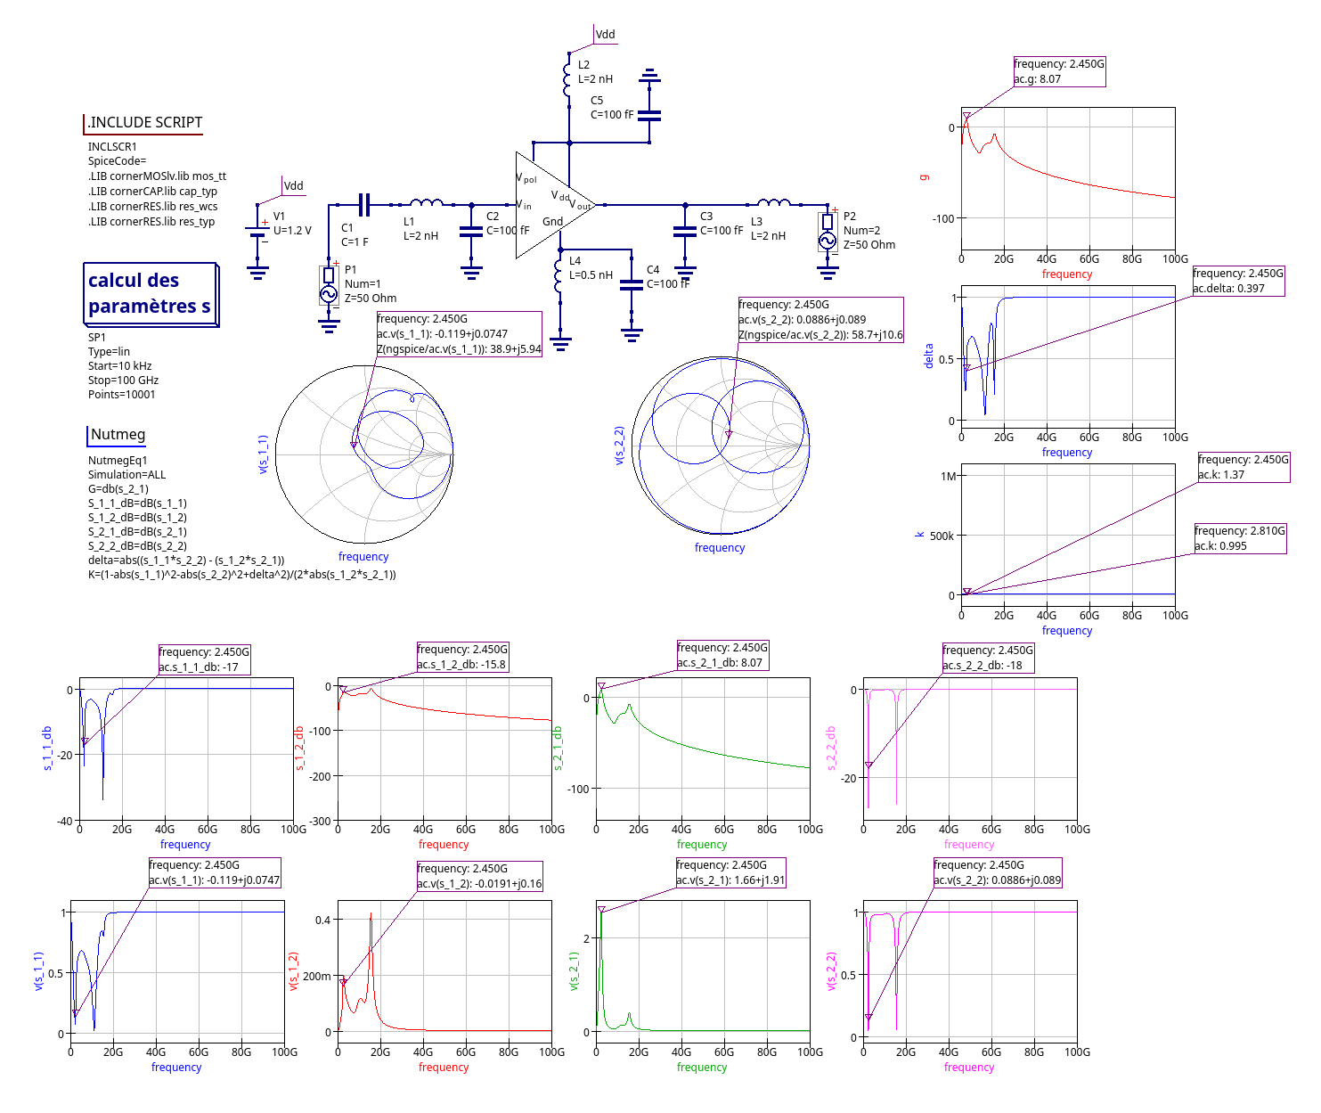
developpement/LNA_Ind_degen/image/LNA_Bench_Parametre_S.png
