Phelma-Promo-MT-2026/ZigBee/developpement/LNA_Ind_degen/image/LNA_Bench_Parametre_S_non_adapt_NF.png

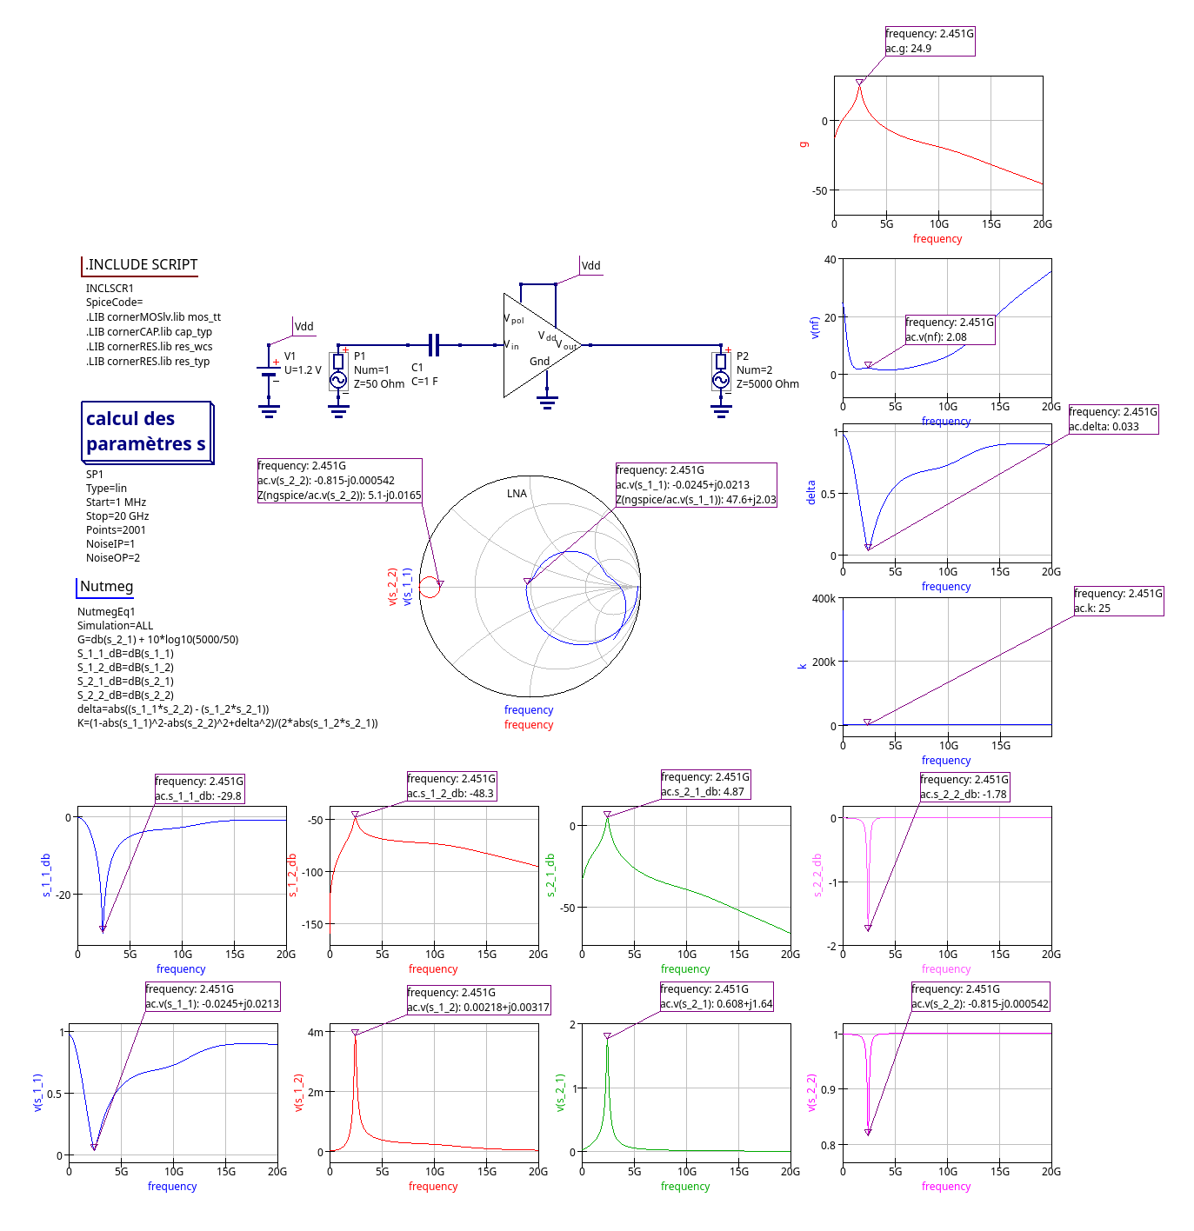
developpement/LNA_Ind_degen/image/LNA_Bench_Parametre_S_non_adapt_NF.png
