Phelma-Promo-MT-2026/ZigBee/developpement/LNA_Ind_degen/image/LNA_non_adapt_sym.png

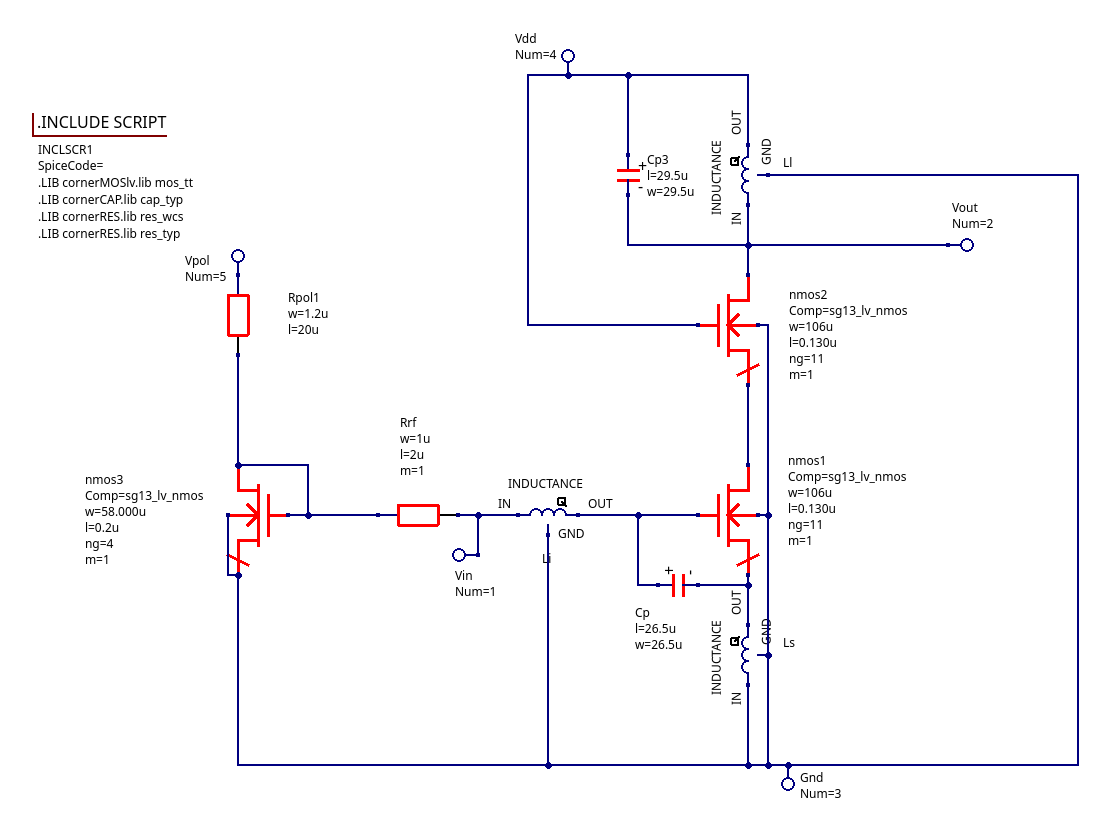
developpement/LNA_Ind_degen/image/LNA_non_adapt_sym.png
