Phelma-Promo-MT-2026/ZigBee/documentation/design/LNA/LNA_Inductance_degenere_synthese.xlsx

Sheet: SYNTHESE_CHECK_LIST
Paramètre | Dimensionnement théorique | Dimensionnement LNA Seul | Dimensionnement LNA final (adapté + bonding) | Unité | Simulation | Commentaires
System
Consommation | 1.2 | 4.49 | 4.49 | mA | DC
Point de polarisation | - | 0.656 | 0.656 | V | DC
IIP3 | -5 | -35.62 | -49.60 | dB | - | Pas réussi à réaliser la simulation IIP3
Gain | 20.0 | 25.8 | 19.8 | dB | Transitoire | Gain différent entre parametre S et Transitoire
NF | 3.5 | 3.2 | 0.8 | dB | Parametres-S | NF a une valeur curieuse
Zin | 50 | 47.6 | 39.4 | Ω | Parametres-S
Point compression | - | -26.02 | -40 | dB | Transitoire
S11 | - | Voir feuille S11 | Voir feuille S11 | - | Parametres-S | -
S22 | - | Voir feuille S22 | Voir feuille S22 | - | Parametres-S | -
S21 | - | Voir feuille S21 | Voir feuille S21 | - | Parametres-S | -
S12 | - | Voir Feuille S12 | Voir Feuille S12 | - | Parametres-S | -
Adaptation entrée
C | 1.41e-12 | 1.3e-12 | - | F | Parametres-S | Capactié de résonnance pour le LNA seul
C1 | - | - | 1.14e-12 | F | Parametres-S | Résonnance + adaptation
C1 {W} | - | - | 2.59e-05 | m | Parametres-S
C1 {L} | - | - | 2.59e-05 | m | Parametres-S
C2 | - | - | 1.74e-12 | F | Parametres-S | Résonnance + adaptation
C2 {W} | - | - | 3.4e-05 | m | Parametres-S
C2 {L} | - | - | 3.4e-05 | m | Parametres-S
Dimensionnement LNA single
gm | 32m | 32m | 32m | S | DC | -
R | 310 | 510 | 510 | Ω | Dependant de L | Résistance dûe aux pertes de l'inductance
L | 3e-09 | 3e-09 | 3e-09 | H | Choix fixé | -
L1 | 1.6e-09 | 1.6e-09 | 1.6e-09 | H | Choix fixé | -
L2 | 3e-09 | 3e-09 | 3e-09 | H | Choix fixé | -
C0 | 8.42e-13 | 1.01e-12 | 1.01e-12 | F | Parametres-S | -
NMOS1 & NMOS2 {W} | 0.000106 | 0.000106 | 0.000106 | m | Choix fixé | -
NMOS1 & NMOS2 {L} | 1.3e-07 | 1.3e-07 | 0.000106 | m | Choix fixé | -
Miroir de courant
NMOS3 {W} | - | 5.8e-05 | 5.8e-05 | m | DC | Dimensionnement nécessaire pour polariser N1 au point DC Vgs = 0,656
NMOS3 {L} | - | 2e-07 | 2e-07 | m | DC
Rpol | - | 130 | 130 | Ω | DC
Rpol {W} | - | 1.2e-06 | 1.2e-06 | m | DC
Rpol {L} | - | 2e-05 | 2e-05 | m | DC
Rrf | - | 5000 | 5000 | Ω | DC
Rrf {W} | - | 1e-06 | 1e-06 | m | DC
Rrf {L} | - | 2e-06 | 2e-06 | m | DC

Sheet: Dimensionnement Théorique
Dimmensionnement théorique (Methode Qe variante design)
 | Cahier des Charges |  |  |  |  |  |  |  |  |  | Linéaire |  | Kn (A/V²) | Cox (F/m²) | Cgs,theorique, adapté50ohm (F) | fT (Hz) | ωT (rad.s-1) | Méthode avec équation du 0,35µ
 | F (dB) | Qe | γ | G (dB) | R0 (Ω) | f0 (Hz) | ω0 (rad.s-1) | L (H) | BW (Hz) |  | F | Gv | 0.0002212596531 | 0.01427481633 | 1.299224025e-12 | 3955692567 | 2.485434941e+10 | IIP3 (dBm) | VeIP3 (V) | Vgs-Vt (V) | Ip (A) | W/L | L (m) | W (m)
 | 3.5 | 1 | 2 | 20 | 50 | 2450000000 | 1.5393804e+10 | 3e-09 | 3000000 |  | 2.24 | 10 |  |  |  |  |  | -5 | 0.18 | 0.07720404444 | 0.001246512101 | 945.179226 | 1.3e-07 | 0.0001228732994
 | gm (S) | C (F) | R (Ω) |  | Ip (A) | W/L | W (m) |  | Cgs (F) | L1 (H) | L2 (H) | C0 (F)
 | 0.03229136789 | 1.406652556e-12 | 309.6802846 |  | 0.0015 | 785.4515617 | 0.000102108703 |  | 1.263238584e-13 | 1.236339733e-09 | 2.01172033e-09 | 1.172900167e-12
 |  |  |  |  |  |  |  |  |  |  |  | 50000000
 |  |  |  |  |  |  |  |  |  |  |  |  | Conso (W)
 |  |  |  |  |  |  |  |  |  |  |  |  | 0.0018
 | Dimensionnement Théorique (avec L2 fixé)
 |  |  |  |  |  |  |  |  |  |  | 100 | 0.1
 | Données fixes |  |  | Détermination C0 |  |  | Détermination L1
 | L2 (H) | Cgs (F) |  | Cgs,theorique, adapté50ohm (F) | C0 (F) |  | L1 (H)
 | 1.5e-09 | 1.263238584e-13 |  | 9.687410367e-13 | 8.424171784e-13 |  | 2.856125641e-09

Sheet: Simulation Parametre_S
SIMULATION PARAMETRES S
AVEC ADAPTATION + BONDING | SANS ADAPTATION
SCHEMA | SCHEMA
#VALUE! | #VALUE!
ADAPTATION EN ENTREE & SORTIE | ADAPTATION EN ENTREE & SORTIE
#VALUE!
#VALUE!
Zin | Zin
#VALUE! | #VALUE!
39.35090342 | 47.6432671
GAIN | GAIN
#VALUE! | #VALUE!
NOISE FACTOR | NOISE FACTOR
#VALUE! | #VALUE!
0.8278537032 | 3.18063335
DELTA | DELTA
#VALUE! | #VALUE!
K | K
#VALUE! | #VALUE!

Sheet: S22
S

Sheet: Simulation transistoire
AVEC ADAPTATION + BONDING |  |  |  |  |  |  |  |  |  |  |  |  | SANS ADAPTATION
Ve |  | Vout (c-c) |  |  |  | Gain |  | Tangente Vout (dB) | diff(Vout-tangente) | GAIN |  | Point de compression (Vin dB) | Ve |  | Vout (c-c) |  |  |  | Gain |  | Tangente Vout (dB) | diff(Vout-tangente) | GAIN |  | Point de compression (Vin dB)
Linéaire | dB | Vout min | Vout max | Linéaire | dB | Linéaire | dB |  |  | Linéaire | dB |  | Linéaire | dB | Vout min | Vout max | Linéaire | dB | Linéaire | dB |  |  | Linéaire | dB
8.4e-06 | -101.5144143 | 0.4525 | 0.45268 | 8e-05 | -81.93820026 | 9.523809524 | 19.57621402 | -81.96168103 | -0.02348077426 | 9.728299964 | 19.75712203 | -40.000 | 8.4e-05 | -81.51441428 | 1.1835 | 1.1839 | 0.0002 | -73.97940009 | 2.380952381 | 7.535014192 | -55.63780851 | 18.34159157 | 19.41535102 | 25.75937221 | -26.021
0.001 | -60 | 0.4429 | 0.46232 | 0.009715 | -40.2511439 | 9.715 | 19.7488561 | -40.111 | 0.1401439013 |  |  |  | 0.001 | -60 | 1.1640 | 1.2033 | 0.01965 | -34.13274891 | 19.65 | 25.86725109 | -34.132 | 0.0007489057711
0.002 | -53.97940009 | 0.4332 | 0.47203 | 0.019425 | -34.23277945 | 9.7125 | 19.74662064 | -34.04163323 | 0.1911462231 | GRAPH |  |  | 0.002 | -53.97940009 | 1.1442 | 1.2228 | 0.0393 | -28.11214899 | 19.65 | 25.86725109 | -28.11380833 | -0.001659334194 | GRAPH
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
2 | 6.020599913 | -0.0552 | 1.6439 | 0.849542 | -1.416302909 | 0.424771 | -7.436902822 | 26.44436677 | 27.86066968 |  |  |  | 2 | 6.020599913 | -0.8368 | 3.8582 | 2.347485 | 7.412056518 | 1.1737425 | 1.391456604 | 31.86219167 | 24.45013516

Sheet: Feuil1
 | Vin |  | Vout
 | 0.666 | 0.646 | 0.548 | 0.357
 | 0.01 |  | 0.0955
RMS | 0.007071067812 |  | 0.0675286976
 | Gain | 19.60006743

Sheet: Paramètres techno
Datasheet Nmos | μn (cm²/V.s) | Eps0(F/m) | EpsR(F/m) | Tox(nm) | W(m) | L(m) | VT(V) | VDD(V) | IdSat(A)
 | 310 | 8.854e-12 | 3.49733e-11 | 2.45 | 1e-05 | 1.3e-07 | 0.5 | 1.2 | 0.0048
 | 0.03
Calcul de Cox | Cox(F/m²) | Cox(fF/μm²)
 | 0.01427481633 | 14.27
Calcul de Kn | Kn(A/V²) | Kn(uA/V²)
 | 0.0002212596531 | 221.26
Pour W=10e-6, on calcule les valeurs en dessous (W peut varier-->dimensionnement bloc)
Calcul de Vdsat | VDsat(V)
 | 0.53
Calcul de Gm | Gm(A/V)
 | 0.01807715375
Calcul de Capa | Cgs/Cgd(F) | Cgs/Cgd(fF) | CMiller(fF/um) | CJunction(fF/um²)
 | 9.278630612e-15 | 9.278630612 | 0.36 | 0.95
Datasheet Pmos | μp (cm²/V.s) | Eps0(F/m) | EpsR(F/m) | Tox(nm) | W(m) | L(m) | VT(V) | VDD(V) | IdSat(A)
 | 200 | 8.854e-12 | 3.49733e-11 | 2.45 | 1e-05 | 1.3e-07 | 0.47 | 1.2 | 0.00215
Calcul de Cox | Cox(F/m²) | Cox(fF/μm²)
 | 0.01427481633 | 14.27
Calcul de Kp | Kp(A/V²) | Kp(uA/V²)
 | 0.0001427481633 | 142.75
Calcul de Vdsat | VDsat(V)
 | 0.44
Calcul de Gm | Gm(A/V)
 | 0.01
Calcul de Capa | Cgs/Cgd(F) | Cgs/Cgd(fF) | CMiller(fF/um) | CJunction(fF/um²)
 | 9.278630612e-15 | 9.28 | 0.36 | 0.95
