Phelma-Promo-MT-2026/ZigBee/documentation/AgriZigbee/Model_de_consommation_v0.xlsx

Sheet: Plan d'action
V1 - a faire pour le 26/05/2025 | V1a | V1b | V2 - pour le 11/06
Variables : - Nombre d'emetteur/récepteur (taille d'exploitation + maillage) - 1 concentrateur Faire plusieurs scénarios de consommation - nombre d'échantillon par jour - temps de com ON - I_on - temp de veille OFF - I_off | Ajout Nombre de capteurs | Synchrone | Protocol CSMA

Sheet: Modele1
Station | Element | Alimentation [V] | conso active[A] |  |  | temps actif [s] sur 12H |  |  | conso veille[A] |  |  | temps veille [s] sur 12H |  |  | Consommation [W/h] |  |  | prix [€] | Référence
 |  |  | min | typ | max | min | typ | max | min | typ | max | min | typ | max | min | typ | max
Station Zigbee | Microcontroleur | 3.3 | N/A | 0.15 | N/A | 5 | 10 | 20 |  | 0.07 |  |  | 43190 |  |  | 2.772733333 |  | 3.59 | https://www.espressif.com/en/products/socs/esp32
 | Puce Zigbee | 1.2 | N/A | 0.057 | N/A |  | 0.008896 |  |  | 2.5e-06 |  |  | 43199.9911 |  |  | 3.616901659e-05
 | Capteurs Humidité et temperature | 4 | N/A | 0.0006 | 0.0015 | 0.0025 | 0.005 | 0.0125 |  | 1.7e-06 |  |  | 43199.995 |  |  | 8.160332389e-05 |  | 3.24 | https://www.mouser.fr/datasheet/2/682/Datasheet_SHT3x_DIS-3539332.pdf
 | Capteur Ph | 4.5 | N/A | 0.09 | N/A |  | 1 |  |  | 0.001 |  |  | 43199 |  |  | 0.05411125 |  |  | https://www.es-france.com/19742-capteur-ph-conductivite-temperature-sans-calibration-oc300-oc1250.html
 | Capteur NPK | 4.5 | 0.004 | 0.01 | 0.02 |  | 1 |  |  |  |  |  | 43199 |  |  | 1.25e-05 |  | 17.79 | https://fr.aliexpress.com/i/1005005684119688.html#nav-moretolove
Station Centrale | Unité centrale | 5 |  | 1.8 |  |  | 1800 |  |  | 0.6 |  |  | 41400 |  |  | 39 |  | 55.56 | https://www.raspberrypi.org/products/raspberry-pi-4-model-b/
 | Puce zigbee | 0 |  | 0.07 |  |  | 0.022276 |  |  | 2.5e-06 |  |  | 43199.97772 |  |  | 0
 | Ecran | 5 |  | 0.84 |  |  | 1800 |  |  | 0 |  |  | 41400 |  |  | 2.1 |  | 19.95 | https://fr.aliexpress.com/item/1005006495532523.html?UTABTest=aliabtest115807_13024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 (https://www.adafruit.com/product/938)
BILAN
N capteurs / stations | N Stations | Taille du champs [Ha] | Prix du kW\h
1 | 12 | 1 | 0.2016
Prix d'achat
Stations | 295.44 |  |  |  |  |  |  | Secondaire |  |  |  | Primaire
Centrale | 75.51 |  |  |  |  |  |  | somme active | 1.01580 |  |  | somme active | 13.20000
Total | 370.95 |  |  |  |  |  |  | Somme passive | 0.23551 |  |  | Somme passive | 3.00000
Consommation |  |  |  |  |  |  |  |  |  |  |  |  | 0.55965
Temps | n [kW/h] | prix consomation[€]
24H | 1.1 | 0.21 €
1 semaine | 7.4 | 1.49 €
1 mois | 29.5 | 5.95 €
1 an | 383.7 | 77.36 €

Sheet: Conso ZigBee
 |  | Conso Blocs |  |  | Conso des blocs
 | temps [s] | Blocs | Consumption [mW] |  | [mA] | [V]
Synchronisation | 0.00128 | LNA | 1.56 |  | 1.3 | 1.2
Transmission/réception | 0.0032 | Mixer | 1.8 |  | 1.5 | 1.2
CSMA-CA | 0.000416 | PLL | 3.6 |  | 3 | 1.2
Acknowledge | 0.000672 | PA | 45.7
Requête | 0.00032 | Baseband circuits | 4.5 |  | https://ieeexplore-ieee-org.sid2nomade-2.grenet.fr/document/6482820
 |  | Total ZigBee [mW]
 |  | 57.1
 |  | η (%) | Pout_PA [dBm] | Pout_PA [mW] | P_PA conso [mW]
 |  | 55 | 14 | 25.12 | 45.67

Sheet: Feuil2
SCENARIO 1 - 2 measurements/day
 | Temps Actif [s] |  |  |  | Conso [mW] |  |  |  |  |  |  |  |  |  |  |  |  |  |  | η (%) | Pout_PA [dBm] | Pout_PA [mW] | P_PA conso [mW]
Offset station | Temps Station Primaire [s] |  | Temps Station Secondaire [s] |  | Conso primaire [mW/h] |  | conso secondaire [mW/h] |  | Conso offset | Conso tot active |  |  |  |  |  | Conso tot |  |  |  | 55 | 14 | 25.11886432 | 45.67066239
 | Min | Max | Min | Max | min | max | min | max |  | Min | Max | nombre stations | Nombre de stations en attente | Nombre de relevé | Temps entre chaque relevé | Min | Max | Conso Blocs
6000 | 0.06 | 5.94 | 0.01 | 0.06 | 7.934814221e-05 | 0.007855466079 | 1.322469037e-05 | 7.934814221e-05 | 0.1388888889 | 0.1389814617 | 0.1468237031 | 6 | 5 | 2 | 12 | 0.1776893819 | 0.1855320281 | Blocs | Consumption [mW]
8000 | 0.08 | 5.92 | 0.01 | 0.08 |  |  |  | 0.0001057975229 | 0.1851851852 | 0.185277758 | 0.1931199994 | 8 | 7 |  |  | 0.2348884559 | 0.2427311022 | LNA | 1.56
10000 | 0.1 | 5.9 | 0.01 | 0.1 |  |  |  | 0.0001322469037 | 0.2314814815 | 0.2315740543 | 0.2394162957 | 10 | 9 |  |  | 0.29208753 | 0.2999301763 | Mixer | 1.8
12000 | 0.12 | 6 | 0.01 | 0.12 |  |  |  | 0.0001586962844 | 0.2777777778 | 0.2778703506 | 0.285712592 | 12 | 11 |  |  | 0.3492866041 | 0.3571292503 | PLL | 3.6
14000 | 0.14 | 6.14 | 0.01 | 0.14 |  |  |  | 0.0001851456652 | 0.3240740741 | 0.3241666469 | 0.3320088883 | 14 | 13 |  |  | 0.4064856782 | 0.4143283244 | PA | 45.7
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
3768 | 86393.84 | 86399.84 | 86399.99 | 86399.84 |  |  |  | 0.002999994444 | 0.04361111111 | 0.04961090451 | 0.04961110694
4239 | 86393.82 | 86399.82 | 86399.99 | 86399.82 |  |  |  | 0.00299999375 | 0.0490625 | 0.0550622934 | 0.05506249583

Sheet: Modèle consoZigBee
ZigBee | Conso actif [mW]
 | 57.13066239 | Station Primaire |  |  |  |  | Station Secondaire |  |  |  |  | Conso total sur 1jour [mW]
 | Conso passif [mW] | Temps [s] /24h |  | Conso [mW] /24h |  | Conso sur 1jour [mW] | Temps [s] /24h |  | Conso [mW] /24h |  | Conso sur 1jour [mW]
 | 0.003 | Actif | Passif | Actif | Passif |  | Actif | Passif | Actif | Passif
 |  | 5.94 | 86394.06 | 0.09426559295 | 0.07199505 | 0.1662606429 | 35 | 86365 | 0.5554369955 | 0.07197083333 | 0.6274078288 | 0.7936684717
 |  | 5.92 | 86394.08 | 0.09394820038 | 0.07199506667 | 0.165943267 | 45 | 86355 | 0.7141332799 | 0.0719625 | 0.7860957799 | 0.9520390469
Nombre de relevé par jour | Nombre de stations | 5.9 | 86394.1 | 0.09363080781 | 0.07199508333 | 0.1656258911 | 55 | 86345 | 0.8728295643 | 0.07195416667 | 0.944783731 | 1.110409622
1 | 6 | 6 | 86394 | 0.09521777065 | 0.071995 | 0.1672127707 | 65 | 86335 | 1.031525849 | 0.07194583333 | 1.103471682 | 1.270684453
2 | 8 | 6.14 | 86393.86 | 0.09743951863 | 0.07199488333 | 0.169434402 | 75 | 86325 | 1.190222133 | 0.0719375 | 1.262159633 | 1.431594035
4 | 10 | 6.16 | 86393.84 | 0.0977569112 | 0.07199486667 | 0.1697517779 | 85 | 86315 | 1.348918418 | 0.07192916667 | 1.420847584 | 1.590599362
 | 12 | 6.18 | 86393.82 | 0.09807430377 | 0.07199485 | 0.1700691538 | 95 | 86305 | 1.507614702 | 0.07192083333 | 1.579535535 | 1.749604689
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
 |  | 24.88 | 86375.12 | 0.3948363556 | 0.07197926667 | 0.4668156223 | 460 | 85940 | 7.300029083 | 0.07161666667 | 7.37164575 | 7.838461372
 |  | 24.96 | 86375.04 | 0.3961059259 | 0.0719792 | 0.4680851259 | 500 | 85900 | 7.934814221 | 0.07158333333 | 8.006397554 | 8.47448268

Sheet: Feuil3
a | c | b² | b
0.14 | 0.2 | 0.0204 | 0.1428285686

Sheet: Modèle-conso-complete
SCENARIO 1 - 1 Measurement/day
3 | Nombre de station | Consommation secondaire |  |  |  |  |  |  |  | Consommation primaire |  |  |  |  |  |  |  | Consommation totale
 |  | Actif [W] | Passif [W] | Temps actif [h] | Temps passif [h] | Consommation active | Consommation passive | Consommation totale / 24h | Consommation [W/h] | Actif [W] | Passif [W] | Temps actif [h] | Temps passif [h] | Consommation active | Consommation passive | Consommation totale / 12h | Consommation [W/h]
1 | 6 | 1.057 | 0.25 | 0.009722222222 | 23.99027778 | 0.01027638889 | 5.997569444 | 6.007845833 | 0.2503 | 13.257 | 3 | 0.001666666667 | 23.99833333 | 0.022095 | 71.995 | 72.017095 | 6.001424583 | 6.251751493
 | 8 | 1.057 | 0.25 | 0.0125 | 23.9875 | 0.0132125 | 5.996875 | 6.0100875 | 0.2504 | 13.257 | 3 | 0.001666666667 | 23.99833333 | 0.022095 | 71.995 | 72.017095 | 6.001424583 | 6.251844896
 | 10 | 1.057 | 0.25 | 0.01527777778 | 23.98472222 | 0.01614861111 | 5.996180556 | 6.012329167 | 0.2505 | 13.257 | 3 | 0.001666666667 | 23.99833333 | 0.022095 | 71.995 | 72.017095 | 6.001424583 | 6.251938299
 | 12 | 1.057 | 0.25 | 0.01805555556 | 23.98194444 | 0.01908472222 | 5.995486111 | 6.014570833 | 0.2506 | 13.257 | 3 | 0.001666666667 | 23.99833333 | 0.022095 | 71.995 | 72.017095 | 6.001424583 | 6.252031701
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
 | 24 | 1.057 | 0.25 | 0.1388888889 | 23.86111111 | 0.1468055556 | 5.965277778 | 6.112083333 | 0.2547 | 13.257 | 3 | 0.006666666667 | 23.99333333 | 0.08838 | 71.98 | 72.06838 | 6.005698333 | 6.260368472

Sheet: Model-conso-complet-v2
 | Element | Alimentation | Courrant actif | Courrant Passif | Consommation
 |  |  |  |  | Actif [W] | Passif [W] | Temps actif [h] | Temps passif [h] | Consommation active | Consommation passive | Consommation totale / 24h | Consommation [W/h] | Consommation (%)
6 | Microcontroleur | 3.3 | 0.15 | 0.07 | 0.495 | 0.231 | 0.01944444444 | 23.98055556 | 0.009625 | 5.539508333 | 5.549133333 | 0.2312 | 7.113322%
 | Zigbee Chip | 1.2 | 0.0475 | 0.0025 | 0.057 | 0.003 | 0.01944444444 | 23.98055556 | 0.001108333333 | 0.07194166667 | 0.07305 | 0.0030 | 0.093641%
 | Temperature and humidity sensor | 4 | 0.0006 | 1.7e-06 | 0.0024 | 6.8e-06 | 0.01944444444 | 23.98055556 | 4.666666667e-05 | 0.0001630677778 | 0.0002097344444 | 8.738935185e-06 | 0.000269%
 | Ph sensor | 4.5 | 0.09 | 0.001 | 0.405 | 0.0045 | 0.01944444444 | 23.98055556 | 0.007875 | 0.1079125 | 0.1157875 | 0.0048 | 0.148426%
 | NPK sensor | 4.5 | 0.01 | 0 | 0.045 | 0 | 0.01944444444 | 23.98055556 | 0.000875 | 0 | 0.000875 | 3.645833333e-05 | 0.001122%
 | Central unit | 5 | 1.8 | 0.6 | 9 | 3 | 0.01944444444 | 23.98055556 | 0.175 | 71.94166667 | 72.11666667 | 3.0049 | 92.444893%
 | Zigbee Chip | 1.2 | 0.0475 | 0.0025 | 0.057 | 0.003 | 0.01944444444 | 23.98055556 | 0.001108333333 | 0.07194166667 | 0.07305 | 0.0030 | 0.093641%
 | Screen | 5 | 0.84 | 0 | 4.2 | 0 | 0.01944444444 | 23.98055556 | 0.08166666667 | 0 | 0.08166666667 | 0.0034 | 0.104687%
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
 | Puce zigbee | 1.2 | 0.0475 | 0.0025 | 0.057 | 0.003 | 0.06944444444 | 23.93055556 | 0.003958333333 | 0.07179166667 | 0.07575 | 0.0032 | 0.097102%
 | Ecran | 5 | 0.84 | 0 | 4.2 | 0 | 0.06944444444 | 23.93055556 | 0.2916666667 | 0 | 0.2916666667 | 0.0122 | 0.373882%
