Phelma-Promo-MT-2026/ZigBee/documentation/design/Assemble/Assemblage_DashBoard.pptx

## Dimensionnement Assemblage DashBoard

Promo MT 2026

## Mixer+VCO-michel

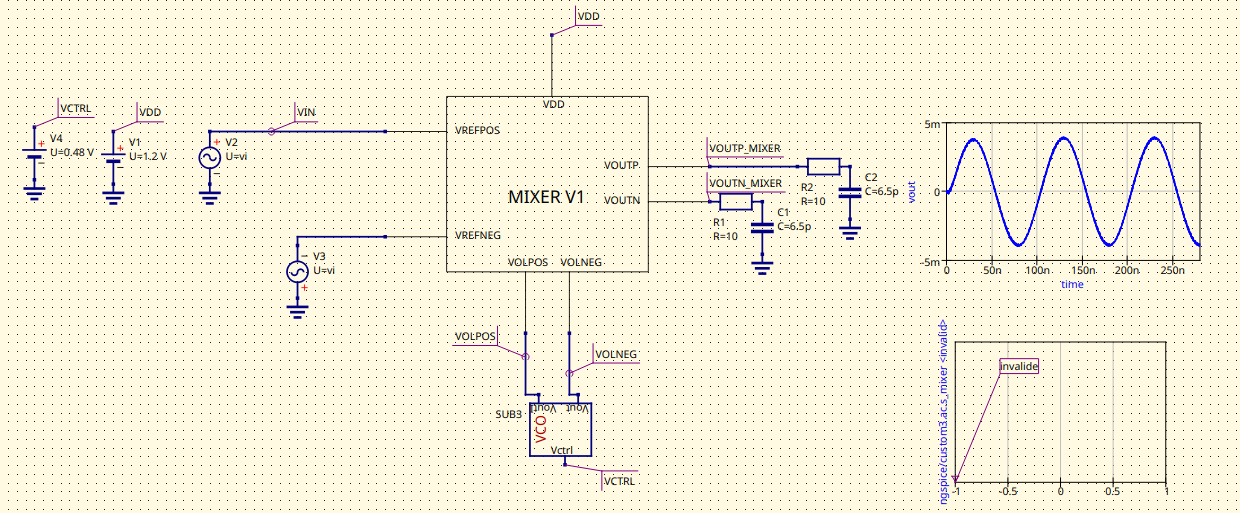
[picture p126: figure]
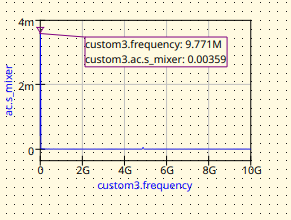
[picture p127: figure]

## VCO_tim

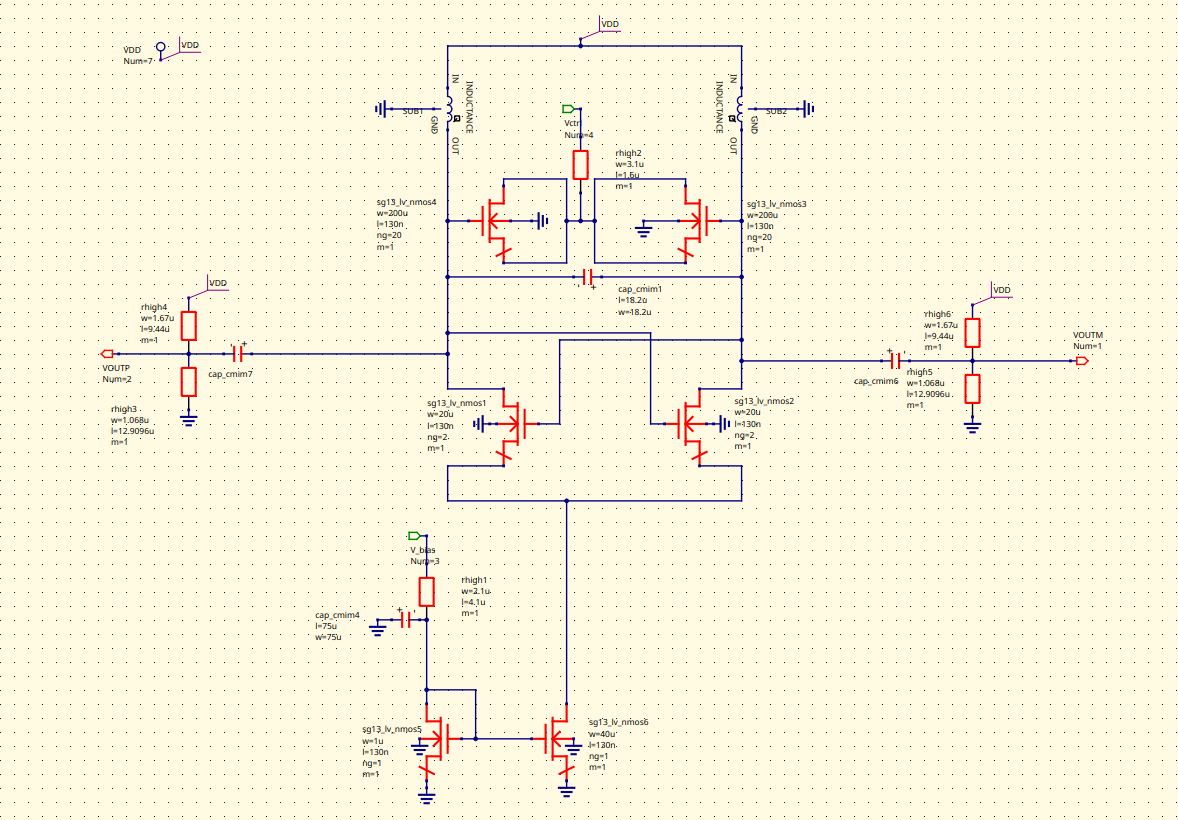
[picture p128: figure]

- Ajout d'une capa de liaison
- Ajout d'un pont diviseur de tension pour avoir 0.8V de polarisation en entrée du mixer

Capture du 2025-06-11 16-14-21

## Mixer+VCO-tim

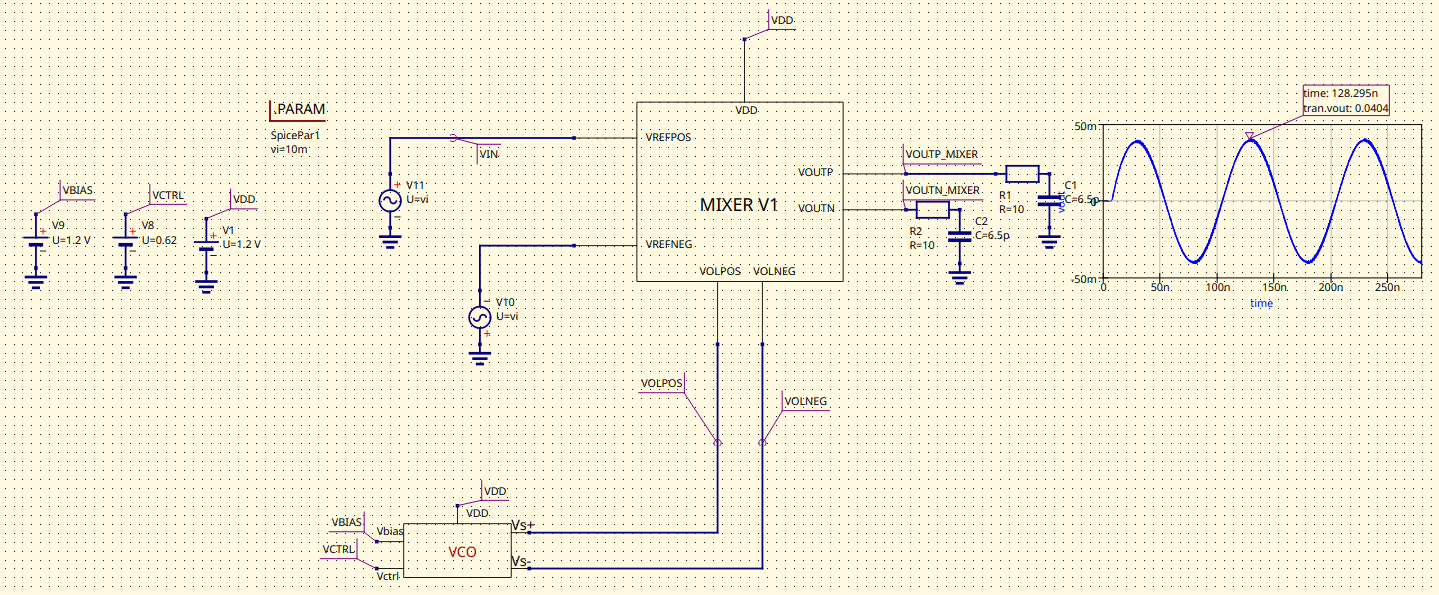
[picture p129: figure]
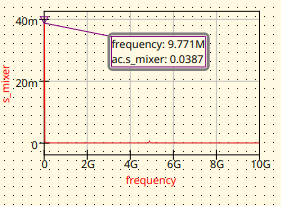
[picture p130: figure]

## LNA+Mixer+VCO-tim

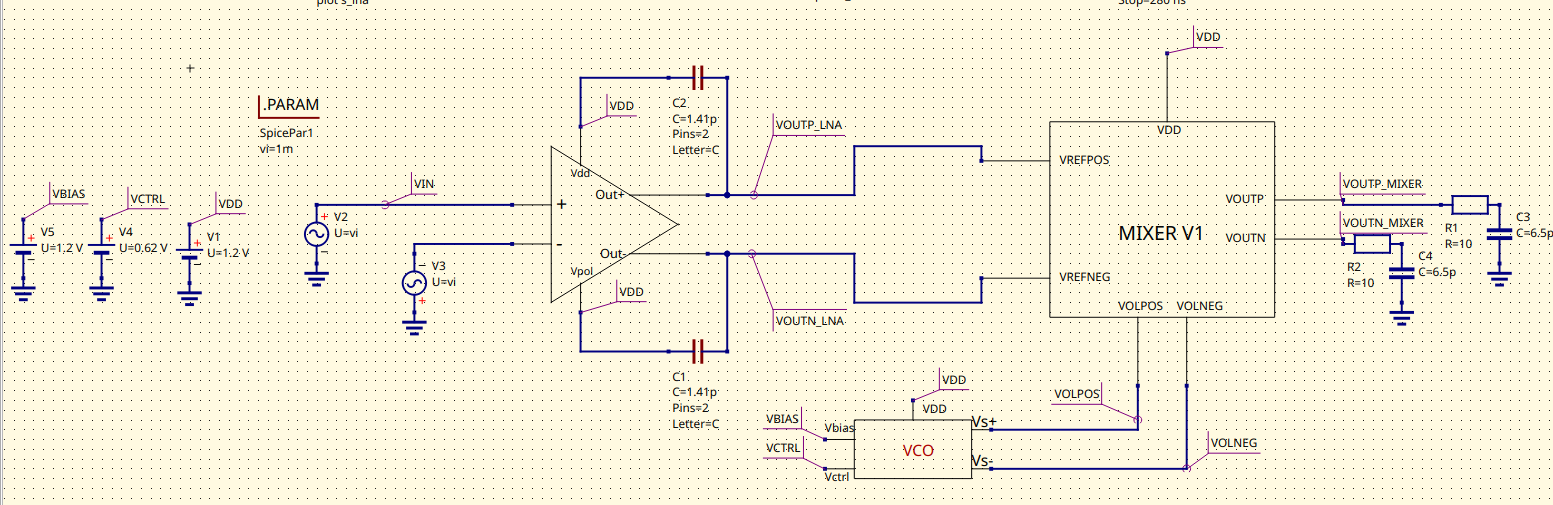
[picture p131: figure]

## Simulation transitoire - tim

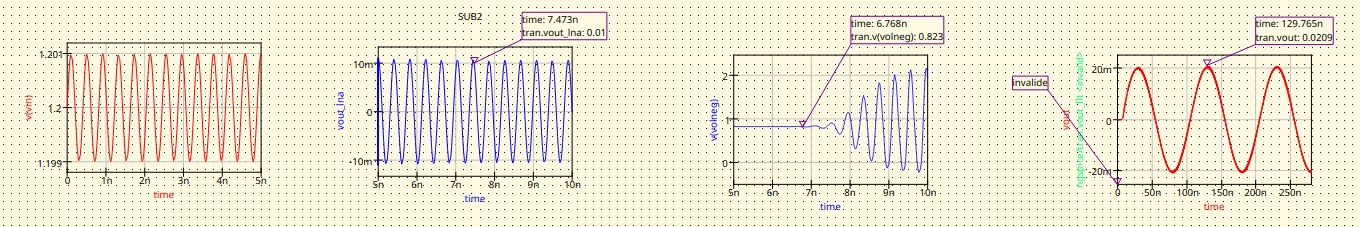
[picture p132: figure]

## Simulation FFT -tim

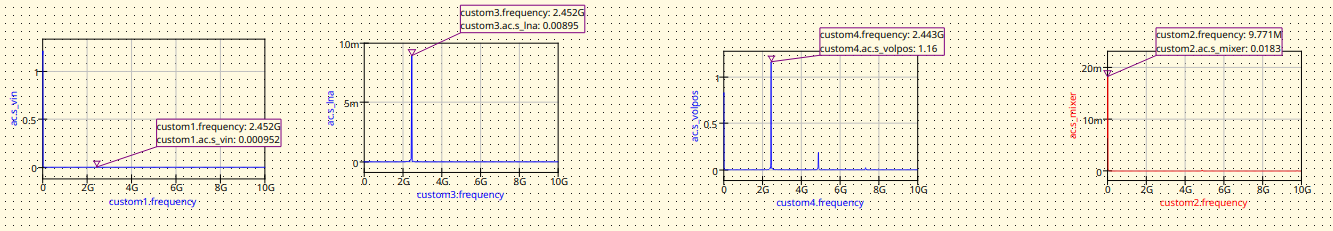
[picture p133: figure]

## LNA+Mixer+VCO-mich

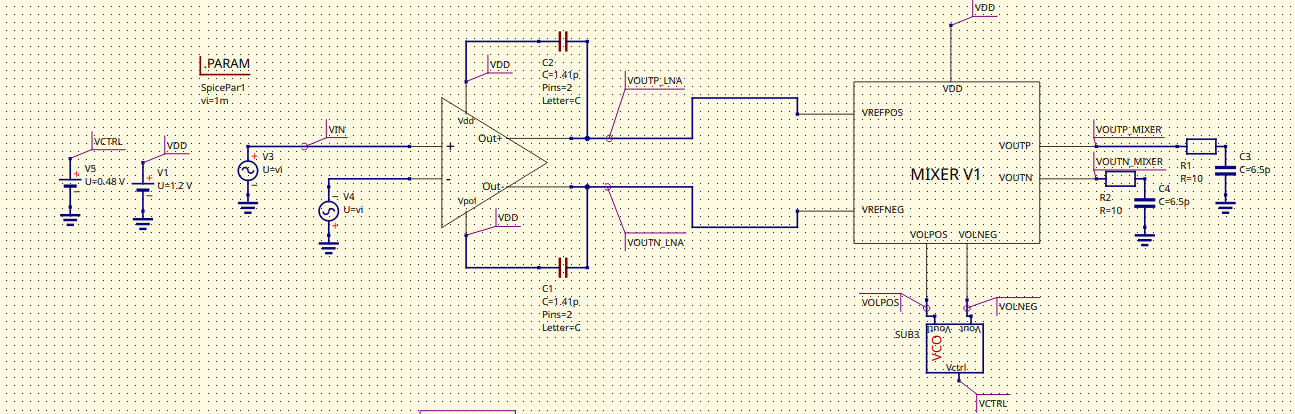
[picture p134: figure]

## Simulation transitoire - mich

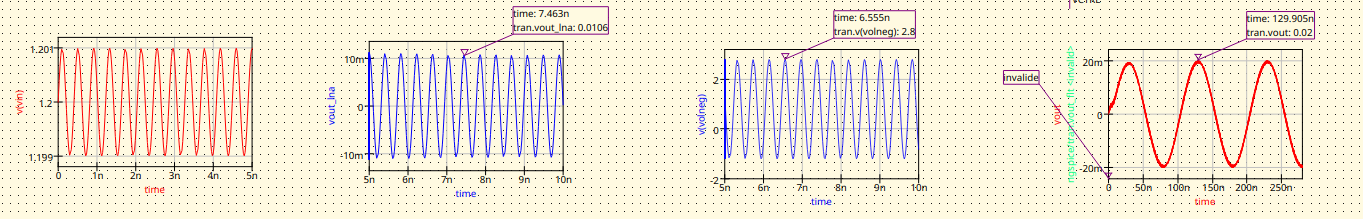
[picture p135: figure]

## Simulation FFT - mich

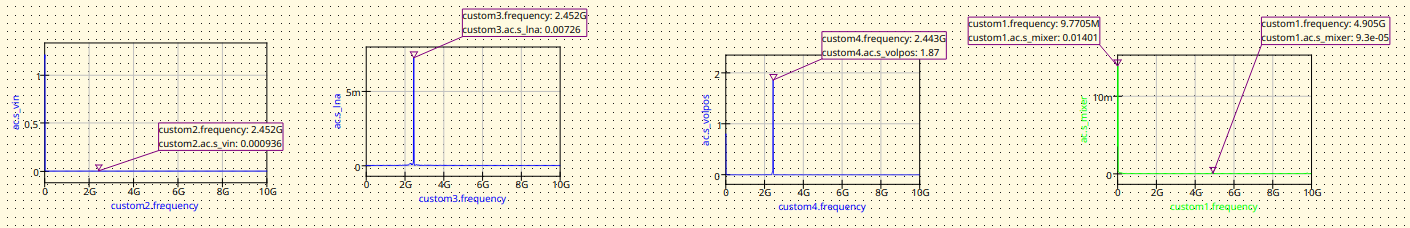
[picture p136: figure]

## Résultats

## LNA+deux mixer- Schéma

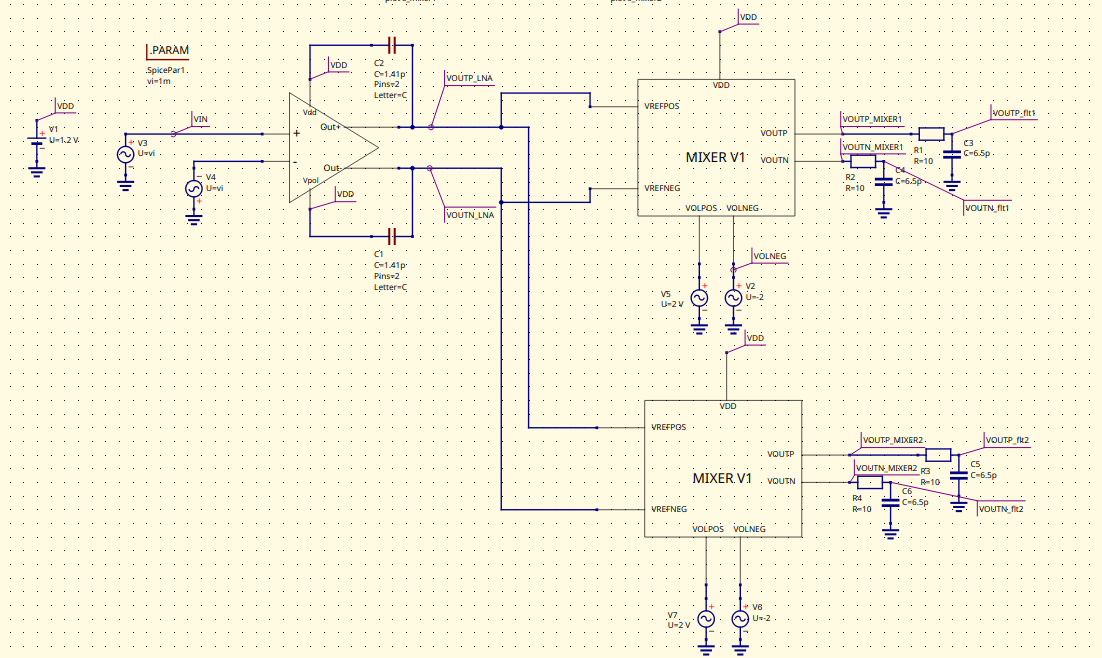
[picture p137: figure]

## Simulation

## Slide 14

RX | Schematic | PLS
Conso (mA) | 7.37mA
IIP3
Gain
NF

## FFT

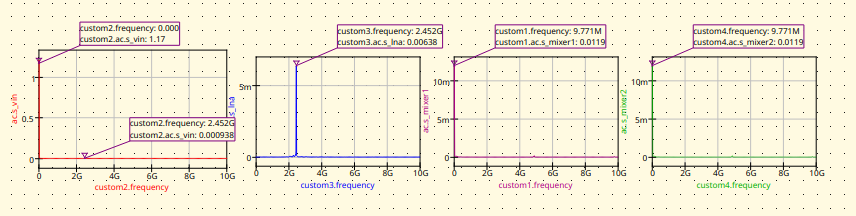
[picture p138: figure]
