Phelma-Promo-MT-2026/ZigBee/documentation/design/Assemble/Assemblage.xlsx

Sheet: Point de compression LNA+mixer
Ve (V) | Ve (dB) | LNA + Mixer (FFT)
 |  | Vout_LNA | Vout_LNA (dB) | Tangente | Diff | Gain_LNA | Vout_Mixer | Vout_Mixer (dB) | Tangente | Diff | Gain_Mixer
0.0001 | -80 | 0.000725 | -62.79323987 | -63.159 | 0.3657601314 | 7.25 | 0.00138 | -57.20241827 | -57.05608798 | -0.1463302912 | 1.903448276
0.0002 | -73.97940009 | 0.00141 | -57.01561775 | -56.97765007 | -0.03796767786 | 7.05 | 0.00273 | -51.27674706 | -51.28539901 | 0.008651946411 | 1.936170213
0.0003 | -70.45757491 | 0.00223 | -53.03390274 | -53.36179216 | 0.3278894165 | 7.433333333 | 0.0043 | -47.33063089 | -47.30846206 | -0.02216883266 | 1.928251121
0.001 | -60 | 0.00718 | -42.87751112 | -42.625 | -0.2525111152 | 7.18 | 0.0139 | -37.13970399 | -37.1642581 | 0.0245541069 | 1.935933148
0.002 | -53.97940009 | 0.0144 | -36.83275016 | -36.44365007 | -0.3891000891 | 7.2 | 0.0283 | -30.96427129 | -31.12675086 | 0.1624795684 | 1.965277778
0.003 | -50.45757491 | 0.022 | -33.15154638 | -32.82779216 | -0.323754228 | 7.333333333 | 0.0427 | -27.3914425 | -27.44996453 | 0.0585220284 | 1.940909091
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
