Phelma-Promo-MT-2026/ZigBee/documentation/Plan_de_Validation.xlsx

Sheet: Inductance
Nom du test | Exigences | Conditions | Procédure | Résultats | Critères d’acceptation | Pass/Fail
Génération de la Pcell | Maitrise de Klayout | Disponibilité de la Pcell | Instancier une Pcell | - | Pas d'erreur sur le terminal | Pass
Simulation EM | .gds de l'inductance | DK EM valide | Simulation EM (openEMS) | - | Réussir à avoir une valeur d'inductance | Pass
Valeur de Ls |  | Boite de paramètres S | Simulation paramètres S | Ls (@f=2,475GHz) = 3nH | Ls=+/- 0,1nH | Pass
Performance de l'inductance | Valeur de Ls=3nH | Test IP3, P1dB | Simulation EM/paramètres S | Q le plus haut possible | Q > 10 | Pass
Modélisation | Schéma équivalent |  | Simulation paramètres S |  | Réussir à avoir une simulation | Pass
Extraction du modèle | Schéma équivalent |  | Tuner les coefficients pour feater | Valeurs des coefficients | Bon feat entre EM et modèle | Pass

Sheet: LNA ID
Nom du test | Exigences | Conditions | Procédure | Résultats | Critères d’acceptation | Pass/Fail
Polarisation entrée LNA | Détermination vgs pour gm = 32mS | - montage cascode - N-MOS identique - W = 106µm - L = 130nm - n gate = 11 | - Sweep en tension sur vgs - Mesure gm = di/dvgs | - Vgs = 0,33V et Ids = 1,3mA pour gm = 32mS - Zone de faible inversion - Relever Ids | Courant et tension correct | Pass
Réseau adaptation entrée | Impédance d'entrée = 50 ohms à 2,45GHz | - Ls = 1,5nH | - Ramener l'impédance sur le cercle de rayon dans smith --> Ajouter capacité entre Grille et source - Ramener l'impédance sur le point 50 ohms --> Ajouter une inductance série en entrée du montage | Co = 0F Li = 3nH | S11 < -10dB | Pass
Réseau adaptation sortie | Maximiser le Gain à 2,45GHz | - LL = 3nH - Rp = 310 ohms | - Faire une analyse paramètre sur Cp en observant le gain à 2,45 GHz | Cp = 700fF | S21 = Gv > 14dB | Pass
Dimensionnement miroir de courant | - Détermination w transistoire miroir - Détermination Rpol | - Montage cascode - L = 130nm | 1/ - Source de courant fixé à 1,3mA (Ids) -> Drain NMOS - Faire varier W et L du mos jusqu'à observer Ids = 1,3mA dans le cascode 2/ - Remplacer source de courant par Rpol - Faire varier Rpol jusqu'à observer Ids = 1,3mA | -W = 205µm -L=0,7µm - Rpol = 670 ohm | 1/ - W acceptable (centaine µ max) 2/ - Ids = 1,3mA - Vgs = 0,33V | Pass
Noise Figure | Facteur de bruit < 2 dB | Vérification du bruit en sortie | Simulation NF | NF < 3,5 dB | Bruit faible
Linearity Test (IP3, P1dB) | Bonne linéarité | Test IP3, P1dB | Injection de.. | IP3 > -10 dBm | Pas de distorsion excessive
Différentiel | Vérification de l'ensemble des paramètres | - Montage différentiel

Sheet: LNA_CG
Type | Nom du test | Exigences | Condition de test | Procédure de test | Résultats | Critères d’acceptation | Pass/Fail | Commentaire
LNA - Single-Ended | Transconductance gm | Transistor Mn2 et Mn1 en régime de saturation (faible inversion) Transistor Mn2 avec un Vdsat = 1,2V | Simu DC Montage Cascode Probe mesure de courant de drain | Sweep sur Vg Calcul de gm Trace de gm en fct de Vgs | gm = 12mS | Complexité des modèles des transistors gm = 20mS | Pass | Modèle complexe des transistors qui ne suit pas les équations linéaire simple
 | Point de polarisation | Transistor Mn2 et Mn1 en régime de saturation (faible inversion) Transistor Mn2 avec un Vdsat = 1,2V | Simu DC Montage Cascode Probe mesure de courant de drain | Sweep sur Vg | Id = 1,3mA | Complexité des modèles des transistors Id = 1mA | Pass | Modèle complexe des transistors qui ne suit pas les équations linéaire simple
 | Miroir de courant | Transistor de réferance capable de fournir un courant fixe dépendant des variations sur Vpol Transistor de courant capable de fournir le même courant | Simu DC Montage miroir de courant Des Probs pour mesure les courants dans les branches Résitance : Rpol pour transformer la tension en un courant de réference | Sweep sur Rpol et W pour un L fixe | Id = 1,3mA | L'erreur max entre les courants dans les deux branches (25µA), 2,08% | Pass
 | gainVsFréqu | Gain relativement constant Gain supérieur à 10dB | Simu AC Composants de la techno | Tracé du gain en fct de la fréqu sur une plage de 5G Hz G = 10log(S21) | G = 15,3 à f = 2,45G Hz | G >= 13 dB (gain théorique) à f = 2,45G Hz | Pass
 | Adaptation en entrée | S11 le plus proche possible du centre de l'abaque à la fréquence de fonctionnement f = 2,45G | Simu AC Réseau d'adaptation | Tunning du réseau | Id = 1,2mA (- de conso) Gain = 15,3dB (+ de gain) S11 = -16,47 dB | S11 <= -10 dB, Gain > 10 | Pass
 | Adaptation en sortie | S22 le plus proche possible du centre de l'abaque à la fréquence de fonctionnement f = 2,45G | Simu AC Réseau capacitif de sortie | Tunning du réseau | Voir abaque | S22 <=-10 dB | Pass
 | Etude du bruit | - | Simu SP Montage single Sans réseau d'adaptation | - | Nf = 5,67 dB | F = 5,051 dB | Pass
LNA - Differential | Layout | DRC clean | DRC maximal lancé dans Klayout | - | 99 erreurs | erreurs restantes ne concernant que la densité de métal | Pass | Reste à ajouter les prises substrat et à condenser le schéma

Sheet: Checklist
Tout circuit
DRC | OUI/NON
LVS | OUI/NON
Simulation avec Bonding | OUI/NON
Stabilité | OUI/NON
Conformité du pad-Ring | OUI/NON
Niveau de hiérarchisation | OUI/NON
Prise substrat | OUI/NON | p
Capas de liaison | OUI/NON
Capas de découplage | OUI/NON
Plan de masse | OUI/NON
Cellule renommée | Na
Librairies auto-consistante | Na
LNA (Single) | Schematic
Conso (mA)
IIP3
Gain
NF
Zin
Fourniture S11 | OUI/NON
Fourniture S12 | OUI/NON
Fourniture S21 | OUI/NON
Fourniture S22 | OUI/NON
NF | OUI/NON
RX | Schematic
Conso (mA) | 7,36
IIP3
Gain
NF
Mismatch IQ (DA et Dj) | OUI/NON
PLL | Schematic
Conso (mA)
Fmin
Fmax
Tr5%
Kvco

Sheet: Mixer 1
Nom du test | Exigences | Condition de test | Procédure de test | Résultats | Critères d’acceptation | Pass/Fail
simulation DC | Ns1 et Ns2 en zone saturée --> vgs0>vth N1, N2, N3, N4 sont des switchs --> pas actifs en mm temps | Vgs de tous les transistors =0,8V | Insérer box simu DC --> Run --> Simulation -->Afficher point de fonctionnement | Vds (transistor) > 0 | les transistors doivent etre en zone saturée, Pas de tension négative,un courant pas trop élevé pour limite la chute de tension au nv des resistances | PASS
simulation transitoire Vout | Une porteuse de Frf-Fol, Une enveloppe de Frf+Fol | Frf=2,45GHz, Vrf=0,4V Fol=2,44GHz, Vol=2V Ip=4,64mA | ajouter sur un nouveau graphique equation vout (voutp-voutn)=fct(time) | -->VIF = 0,6[+-0,1V] -->ABS(FRF-FOL)=10MHz | -->VIF = 0,7V -->ABS(FRF-FOL)=10MHz +/-10% | PASS
fft (vout) | Deux raies doivent être visibles dans le spectre du signal de sortie : une à Frf-Fol et une à Frf+Fol | Frf=2,45GHz, Vrf=0,4V Fol=2,44GHz, Vol=2V Ip=4,64mA | ajout un script pour calculer la fft de la sortie (voutp-voutn) | deux harmoniques visibles: --> Une à 9,77MHz avec une magnitude de 0,643V -->Une à 4,895GHz avec un magnitude de 0,418V | Deux harmoniques: -->Une à 10MHz(Frf-Fol=Fif)avec une magnitude de 0,7V -->Une à 4,89GHz Frf+Fol) +/-10% | PASS
Gain | Le gain doit être relativement constant sur toute la plage des tensions d’entrée testées. La réponse du circuit doit être linéaire Identifier le point de compression à 1dB | Frf=2,45GHz, Vrf=100µV, 1mV, 10mV, 100mV, 200mV, 300mV, 400mV, 500mV Fol=2,44GHz, Vol=2V Ip=1,5mA | En utilisant le bench de la fft, on fait varier la tension d'entrée et on relève l'amplitude de sortie à 10MHz. Sur excel, on trace les courbes vs(ve) et Pout (Pin) et on relève le point de compression ainsi que le gain | gain = 11,08 dB IIP3 = 0,15 V | gain = 8 dB Vinmax= 30mV pour Dmin=0,16m +/-10% | PASS

Sheet: Mixer 2
Nom du test | Exigences | Condition de test | Procédure de test | Résultats | Critères d’acceptation | Pass/Fail
simu DC | Ns1 et Ns2 en zone saturée --> vgs0>vth N1, N2, N3, N4 sont des switchs --> pas actifs en mm temps | Vgs de tous les transistors =0,8V | Insérer box simu DC --> Run --> Simulation -->Afficher point de fonctionnement | Vds (transistor) >0 | les transistors doivent etre en zone saturée, Pas de tension négative,un courant pas trop élevé pour limite la chute de tension au nv des resistances | PASS
simulation transitoire Vout | Une porteuse de Frf-Fol, Une enveloppe de Frf+Fol | Frf=2,45GHz, Vrf=0,4V Fol=2,44GHz, Vol=2V Ip=4,64mA | ajouter sur un nouveau graphique equation vout (voutp-voutn)=fct(time) | -->VIF = 0,6[+-0,1V] -->ABS(FRF-FOL)=10MHz | -->VIF = 0,7V -->ABS(FRF-FOL)=10MHz +/-10% | PASS
fft (vout) | Deux raies doivent être visibles dans le spectre du signal de sortie : une à Frf-Fol et une à Frf+Fol | Frf=2,45GHz, Vrf=0,4V Fol=2,44GHz, Vol=2V Ip=4,64mA | ajout un script pour calculer la fft de la sortie (voutp-voutn) | deux harmoniques visibles: --> Une à 9,77MHz avec une magnitude de 0,657V -->Une à 4,895GHz avec un magnitude de 0,419V | Deux harmoniques: -->Une à 10MHz(Frf-Fol=Fif)avec une magnitude de 0,7V -->Une à 4,89GHz Frf+Fol) +/-10% | PASS
Gain | Le gain doit être relativement constant sur toute la plage des tensions d’entrée testées. La réponse du circuit doit être linéaire Identifier le point de compression à 1dB | Frf=2,45GHz, Vrf=100µV, 1mV, 10mV, 100mV, 200mV, 300mV, 400mV, 500mV Fol=2,44GHz, Vol=2V Ip=1,5mA | En utilisant le bench de la fft, on fait varier la tension d'entrée et on relève l'amplitude de sortie à 10MHz. Sur excel, on trace les courbes vs(ve) et Pout (Pin) et on relève le point de compression ainsi que le gain | gain = 8,45 dB IIP3 = 0,175 V | gain = 8 dB Vinmax= 30mV pour Dmin=0,16m +/-10% | PASS

Sheet: PLL
VCO
Nom du test | Exigences | Condition de test | Procédure de test | Résultats | Critères d’acceptation | Pass/Fail
L,C "IDEAUX"
Simulation paramètre S | Valeurs d'inductance proche de la valeur théorique de départ : L = 6nH, Q= 11,7@2,45GHz | inductance idéale | Analyse S param [0,10GHz] Analyses des valeurs de Ls, Cs à partir des équations Z11,Y11... | L= 6,08 nH Q = 11,7@2,45GHZ | +/-10% | Pass
Caractérisation OL | L= 6nH, C=694fF Rp ~kOhms | composant idéaux | Analyse S param | L= 6,08nH, C = 696 fF Rp = 1,09kOhms | +/- 10% | Pass
Dimensionnement paire croisée | R- < Rp, on choisit R-/3 pour avoir de la marge R- = -400 Ohms | Valeur des transistors PDK déterminée de manière théorique. Avec ordre de grandeur de W choisit ~15um | Analyse S param | R(CPP) ~= R-/3 = -410 | +/-10% | Pass | => Dimensionnement transistor CPP ? Tune entre courant et W transistor ?
Oscillation VCO | Vérification d'oscillation à la fréquence de foncitonnement |  | Analyse transient [5;15ns] step 10pF | F(mos1) = F(mos2) = Foscillation = 2,45GHz | +/-10% | Pass
L,C "réel"
Caractérisation éléments du OL | Valeurs d'inductance proche de la valeur théorique de départ : L = 6nH, Q= 11,7@2,45GHz | Inductance fichier paramètres S Capa mim PDK | Analyse S param [0,10GHz] de Ls, Cs à partir des équations Z11,Y11... | L= 6,08 nH Q = 11,7@2,45GHZ | +/-10% | Pass
Dimensionnement paire croisée | R- < Rp, on choisit R-/3 pour avoir de la marge R- = -363 Ohms | Valeur des transistors PDK déterminée de manière théorique. Avec ordre de grandeur de W choisit ~15um | Analyse S param de Rp (eq Y11..) Tunage de W/L, et de Io pour avoir une valeur de resistance conforme | R(CPP) ~= R-/3 = -372 | +/- 10% | Pass
Oscillation VCO | Vérification d'oscillation à la fréquence de foncitonnement | L = Inductance fichier paramètres S C = Capa mim PDK | Analyse S param avec un port d'impédance infinie | R tot = -565 < 0 signifie qu'il y a un générateur Im(Y11) = 0 @foscillation | +/-10% | Pass
Caractérisation diodes |  |  |  |  |  | FAIL
Caractérisation transistor |  |  |  |  |  | Pass
Oscillation VCO
Source de courant réel avec miroir de courant
Buffer de sortie
Validation VCO
Diviseur de Fréquence
Nom du test | Exigences | Condition de test | Procédure de test | Valeurs attendues | Critères d’acceptation | Pass/Fail
Simulation en régime transitoire | Tracer la courbe de sortie (celle de la boucle ) | 2 clocks de même période et de même amplitude mais de phase opposée |  | Division par 4 de la fréquence | +/-0% | PASS
Détermination de la table de vérité sur 2 cycles d'horloge | Obtenir la table de vérité du circuit pour le paramétrer étage par étage | 2 clocks de même période et de même amplitude mais de phase opposée et entrée à 0 | Calculs de short/open avec les transistors NMOS et PMOS | 1010(clock) => 1100 (sortie) | +/-0% | PASS
Pompe de charge
Nom du test | Exigences | Condition de test | Procédure de test | Valeurs attendues | Critères d’acceptation | Pass/Fail
Inverseur 1x, 2x | Table de vérité | L=Lmin=130nm, Wn1x=150nm, Wb=300nm | transcient | 0 -> 1 1 -> 0 | Table de vérité respectée | PASS
NAND 2 et 3 entrées | Table de vérité | L=Lmin=130nm, Wn=150nm, Wb=300nm | transcient | 0|0|0 ->1 . . 1|1|1 -> 0 | Table de vérité respectée | PASS
AND 2 entrées | utilisation de symboles et sub-circuit | NAND2 + INV1x | transcient | 0|0->0 0|1->0 1|0->0 1|1->1 | Table de vérité respectée et charge de la capacité d'entrée de l'inverseur | PASS
Bascule D | Table de vérité et capacité de charge en sortie | circuit composé de NAND2 + INV1x + NAND3 | transcient | recopie du signal d'entrée sur front montant de la clock, reset fonctionnel | Table de vérité? | PASS
Pompe de charge | Générer un courant I = -I0 ; 0 ou I0 (I0 = 100µA) | circuit composé de Bascule D,INV1x , 2x AND2 et comparateur de phase | transcient | f fdiv < f ref -> I = +I0 f fdiv > f ref ->I = -I0 f fdiv > f ref ->I = 0 |  | FAIL
Nom du test | Exigences | Condition de test | Procédure de test | Valeurs attendues | Critères d’acceptation | Pass/Fail
