Phelma-Promo-MT-2026/ZigBee/documentation/design/Inductance/test_calcul_inductor.xlsx

Sheet: diff_inductor
 |  |  | L Model formula source: https://ieeexplore.ieee.org/document/6231846 (https://sci-hub.st/10.1109/OPTIM.2012.6231846) |  |  |  |  |  |  |  | Sim often @2.475GHz instead of 2.45GHz
 | permeability µ= | 1.16e-06 | -> how to find a good/real value |  |  | in openems constant, topmetal2 as sigma (conductivity) at 3.03e7
N | W | S | di (diam inner) | de (diam extern) | dm | ρ | L | L (sim) | Error | Rs (sim) | Q (sim) | Rp
1 | 5e-06 | 2.1e-06 | 1.548e-05 | 2.548e-05 | 2.048e-05 | 0.244140625 | 2.877112802e-11 | 5.803e-11 | 50.42% | 0.37 | 2.44 | 2.54
2 | 5e-06 | 2.1e-06 | 1.548e-05 | 3.968e-05 | 2.758e-05 | 0.4387237128 | 1.15678485e-10 | 3.5059e-11 | 229.95% | 2.35 | 2.29 | 14.73
3 | 5e-06 | 2.1e-06 | 1.548e-05 | 5.388e-05 | 3.468e-05 | 0.553633218 | 2.852019273e-10 | 1.346438e-09 | 78.82% | 4.85 | 4.27 | 93.36
4 | 5e-06 | 2.1e-06 | 1.548e-05 | 6.808e-05 | 4.178e-05 | 0.6294877932 | 5.630109167e-10 | 2.3800059e-09 | 76.34% | 6.54 | 5.60 | 211.49
5 | 5e-06 | 2.1e-06 | 1.548e-05 | 8.228e-05 | 4.888e-05 | 0.6833060556 | 9.751014887e-10 | 3.887239e-09 | 74.92% | 9.11 | 6.56 | 401.19
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
