Phelma-Promo-MT-2026/ZigBee/developpement/Inductance/development/Modele_Inductance/modele_performance_3.png

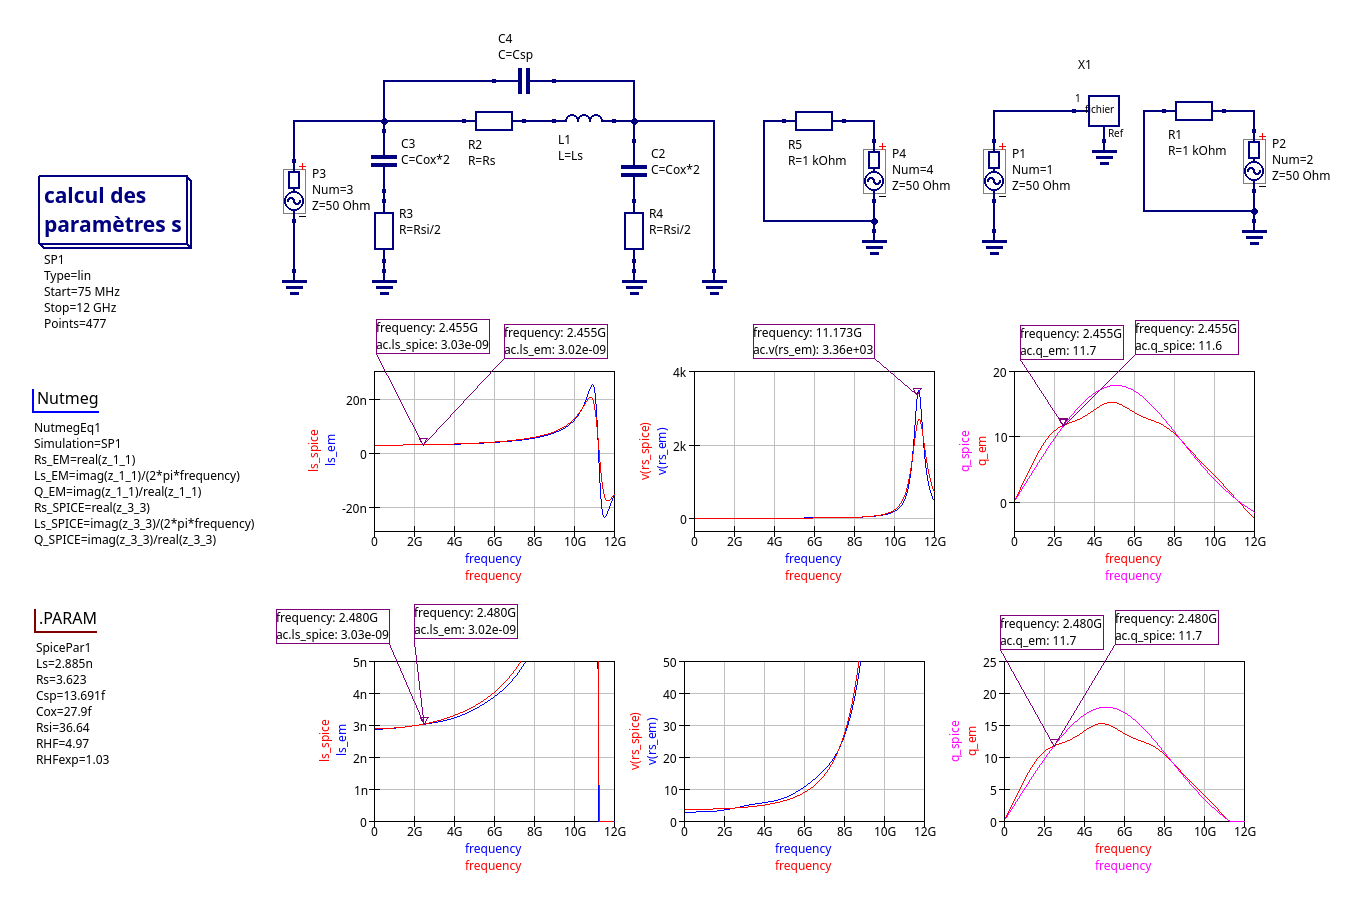
developpement/Inductance/development/Modele_Inductance/modele_performance_3.png
