Phelma-Promo-MT-2026/ZigBee/developpement/LVS/qucs/IHP_PDK_nonlinear_components_sg13_lv_nmos_extracted.cir

* Extracted by KLayout with SG13G2 LVS runset on : 11/06/2025 15:08

.SUBCKT IHP_PDK_nonlinear_components_sg13_lv_nmos
M$1 GND \$4 VDD \$1 sg13_lv_nmos L=0.13u W=0.15u AS=0.1005p AD=0.1005p PS=1.34u
+ PD=1.34u
.ENDS IHP_PDK_nonlinear_components_sg13_lv_nmos
