Phelma-Promo-MT-2026/ZigBee/developpement/LVS/LAYOUT/test_nmos/test_nmos_extracted.cir

* Extracted by KLayout with SG13G2 LVS runset on : 11/06/2025 14:50

.SUBCKT test_nmos GND VDD VIN
M$1 VDD VIN GND GND sg13_lv_nmos L=0.13u W=0.15u AS=0.1005p AD=0.1005p PS=1.34u
+ PD=1.34u
.ENDS test_nmos
