Phelma-Promo-MT-2026/ZigBee/developpement/LVS/LAYOUT/test_nmos/TOP_extracted.cir

* Extracted by KLayout with SG13G2 LVS runset on : 11/06/2025 14:12

.SUBCKT TOP
M$1 VDD VIN GND GND sg13_lv_nmos L=0.13u W=0.15u AS=0.1005p AD=0.1005p PS=1.34u
+ PD=1.34u
.ENDS TOP
