Phelma-Promo-MT-2026/ZigBee/(commit log)

2025-03-27 ajout des principaux dossiers
2025-03-27 Commit initial
    [premiers_tests_grille_commune.sch, test_nmos_id_gm.sch]
2025-03-27 creation dossiers persos
    [premiers_tests_grille_commune.sch, test_nmos_id_gm.sch]
2025-03-31 première simulation gm
    [extraction_gm.sch]
2025-04-01 Les simulations commencent a marcher
    [premiers_tests_grille_commune.sch, test_nmos_id_gm.sch]
2025-04-07 Premiere simulation inductance 7nH
    [Inductance_S1P_7nH.sch]
2025-04-08 ajout schema LNA
    [LNA_cascode.sch, extraction_gm.sch, simulation_LNA_cascode.sch]
2025-04-08 ajout LNA simu parametre S
    [LNA_cascode.sch, extraction_gm.sch, simulation_LNA_cascode.sch]
2025-04-08 clean folder Inductance
    [Inductance_S1P_7nH.sch]
2025-04-08 sch gc MAJ+ Simu point DC
    [SchemaCG_Basic.sch, SchemaCG_LNA_Single.sch]
2025-04-08 extraction gm cascode
    [LNA_cascode.sch, extraction_gm.sch, simulation_LNA_cascode.sch]
2025-04-08 sch gc MAj+ Simu point DC + nettoyage
    [Extrac_gm.sch, SchemaCG_LNA_Single.sch]
2025-04-10 Librairie Inductance Update 6nH_bis
    [Inductance_S1P_1.2nH.sch, Inductance_S1P_4.9nH.sch, Inductance_S1P_6nH.sch, Inductance_S1P_7nH.sch]
2025-04-10 clean bench
    [LNA_cascode_gain.sch, LNA_cascode_gm.sch, extraction_gm_seul.sch]
2025-04-10 mise à jour LNA_Grille_Comm
    [SchemaCG_LNA_Single.sch]
2025-04-10 rename schematic
    [Gm_NMOS_Cascode.sch, Gm_NMOS_seul.sch, LNA_single_comp_parfait.sch, simulation_LNA_cascode.sch]
2025-05-12 Inductance 3nH
    [Inductance_S1P_1.1nH.sch, Inductance_S1P_1.6_serienH.sch, Inductance_S1P_1.6nH.sch, Inductance_S1P_3.3nH.sch, Inductance_S1P_4.2nH.sch]
2025-05-13 Single-Ended terminé peut-être
    [Extrac_gm.sch, SchemaCG_LNA_Miroir.sch, SchemaCG_LNA_Single.sch]
2025-05-13 Single-ended fonctionnel (peut etre)
    [SchemaCG_LNA_Miroir.sch]
2025-05-13 ajout bench Brice
    [extraction_gamma.sch, premiers_tests_grille_commune.sch, test_nmos_id_gm.sch]
2025-05-13 Inductance haute performance ok
    [Inductance_S1P_3nH.sch, Inductance_S1P_3nH_High_Q.sch]
2025-05-13 Photo dashboard inductance
    [Inductance_S1P_3.2nH_High_Q.sch]
2025-05-13 Single-ended avec miroir pour l'adaptation en sortie
    [SchemaCG_LNA_MiroirCascode.sch, SchemaCG_LNA_Miroir_AdapSortie.sch, SchemaCG_LNA_Miroir_SourceIdeale.sch, SchemaCG_LNA_Single.sch, Verif_miroir.sch]
2025-05-13 miroir fonctionnel a tuner ave rpol
    [SchemaCG_LNA_Miroir.sch, SchemaCG_LNA_Miroir_cascode.sch]
2025-05-14 sweep pas mal sur mriroir
    [SchemaCG_LNA_Miroir_cascode.sch]
2025-05-14 ajout LNA sigle premier simu
    [Gm_NMOS_Cascode.sch, LNA_single_comp_parfait.sch]
2025-05-14 before merge dev
    [SchemaCG_LNA_Miroir_AdapSortie.sch]
2025-05-14 Ajout photo bench
    [Capacite_rfcmim.sch, Inductance_S1P_3nH.sch, Resistance_Rhigh.sch, Resistance_Rppd.sch, Resistance_Rsil.sch]
2025-05-14 first simu with real ind
    [LNA_single.sch]
2025-05-14 LNA adapté
    [SchemaCG_LNA_Miroir_AdapSortie.sch]
2025-05-15 pull derniere simu
    [SchemaCG_LNA_Miroir_AdapSortie.sch]
2025-05-15 LNA finalisé
    [SchemaCG_LNA_Miroir_AdapSortie_real.sch, SchemaCG_LNA_single_complet_noise.sch]
2025-05-15 tentative de bruit
    [SchemaCG_LNA_single_complet_noise.sch]
2025-05-15 ajout LNA single reel
    [Gm_NMOS_Cascode.sch, Gm_NMOS_Cascode_miroir_full.sch, Gm_NMOS_Cascode_miroir_source.sch, Gm_NMOS_seul.sch, LNA_single.sch, LNA_single_comp_parfait.sch, LNA_single_comp_parfait_DC.sch, LNA_single_comp_parfait_miroir.sch]
2025-05-15 Idée modèle d'inductance [en cours]
    [Capacite_cmim.sch, Extraction_modele_IND_1P.sch, Inductance_2P_3nH_High_Q.sch, Inductance_TEST_2Psch.sch]
2025-05-16 Etape iterative
    [Bench_LNA_CG_Diff.sch, SchemaCG_LNA_Diff.sch, SchemaCG_LNA_Miroir.sch, SchemaCG_LNA_Miroir_AdapEntree_real.sch, SchemaCG_LNA_Miroir_Adaptation.sch, SchemaCG_LNA_Miroir_SourceIdeale.sch, SchemaCG_LNA_Single.sch, SchemaCG_LNA_single_complet_noise.sch]
2025-05-16 giga push
    [Capacite_cmim.sch, Resistance_Rhigh.sch, Resistance_Rppd.sch, SchemaCG_LNA_single_complet_noise.sch]
2025-05-16 Ajout Fichier GDS Inductance 3nH / DRC clean sauf dummies
    [Extraction_modele_IND_1P_V2.sch, Extraction_modele_IND_2P.sch, Extraction_modele_IND_2P_V2.sch, Inductance_2P_3nH_High_Q_1P_view.sch]
2025-05-19 Ajout du modèle d'inductance
    [Extraction_modele_IND_1P_V2.sch, Modele_Inductance.sch]
2025-05-19 Etape iterative : lna single complet
    [SchemaCG_LNA_Miroir.sch, SchemaCG_LNA_Miroir_AdapSortie_real.sch, SchemaCG_LNA_Miroir_Adaptation.sch, SchemaCG_LNA_Miroir_Adaptation_real.sch, SchemaCG_LNA_Miroir_Gain_Real.sch, SchemaCG_LNA_Single_OptiConsosch.sch]
2025-05-19 ajout LNA Single full
    [LNA_diff.sch, LNA_diff_simu.sch, LNA_single_comp_parfait_miroir.sch, LNA_single_full.sch, LNA_single_full_1.sch, LNA_single_simu.sch]
2025-05-20 ajout bench finaux
    [Gm_NMOS_Cascode.sch, Gm_NMOS_Cascode_miroir_full.sch, Gm_NMOS_Cascode_miroir_source.sch, Gm_NMOS_seul.sch, LNA_diff.sch, LNA_diff_simu.sch, LNA_single.sch, LNA_single_comp_parfait.sch]
2025-05-20 correctif simu
    [LNA_diff.sch, LNA_single.sch, LNA_single_full.sch, Simu_LNA_Single.sch, Simu_LNA_diff.sch, reseau_adaptation_out.sch]
2025-05-20 Bench Single
    [Bench_LNA_CG_Diff.sch, Bench_LNA_CG_Single.sch, SchemaCG_LNA_Diff.sch, SchemaCG_LNA_Miroir_Adaptation_real.sch, SchemaCG_LNA_Single.sch, SchemaCG_LNA_Single_OptiConsosch.sch, Symbole_LNA_CG_Diff.sch, Symbole_LNA_CG_Single.sch]
2025-05-20 simu single complete
    [Simu_LNA_Single.sch]
2025-05-21 layout single avancé
    [SchemaCG_LNA_single_complet_noise.sch, tests_diff.sch]
2025-05-21 Ajout tb_mixer depuis la branche mixer
    [mixer.sch, tb_mixer_v2.sch]
2025-05-21 ajustement du mixer
    [gain_mixer_v2.sch, mixer.sch]
2025-05-21 correctif LNA diff
    [LNA_diff.sch, Simu_LNA_Single.sch, Simu_LNA_diff.sch]
2025-05-21 correctif : clean LNA grille comm
    [Bench_LNA_CG_Diff.sch, Bench_LNA_CG_Single.sch, Extrac_gm.sch, SchemaCG_Basic.sch, SchemaCG_LNA_Diff.sch, SchemaCG_LNA_Miroir.sch, SchemaCG_LNA_MiroirCascode.sch, SchemaCG_LNA_Miroir_AdapSortie.sch]
2025-05-23 Correction des erreurs
    [fft_mixer_v2.sch, mixer.sch, tb_mixer_v2.sch]
2025-05-23 LNA DIFF CG, branche LNA vers la branche main
    [Bench_LNA_CG_Diff_SansReseau.sch, Symbole_LNA_CG_Diff.sch]
2025-05-23 Suppression des fichiers inutiles
    [gain_mixer_v2.sch]
2025-05-23 Main, reseau d'adaptation sortie lna CG
    [Symbole_ReseauAdapt_Sortie.sch]
2025-05-23 ajout du mixer version 1
    [mixer_sh.sch, tb_mixer_v1.sch]
2025-05-23 ajout point de fonctionnement mixer v1
    [pt_fonc_mixer_v1.sch]
2025-05-23 premier jet d'assemblage
    [fft_mixer_v1.sch, fft_mixer_v2.sch, mixer.sch, mixer_sh.sch, pt_fonc_mixer_v1.sch, tb_mixer_v1.sch, tb_mixer_v2.sch]
2025-05-27 Ajout du dossier Asseemblage
    [LNA_GC_mixer_V1.sch]
2025-05-27 montage diff à jour pour la branche main
    [Symbole_LNA_CG_Diff.sch]
2025-05-27 bon fonctionnement du mixer v1 + bon assemblage
    [LNA_GC_mixer_V1.sch, LNA_GC_mixer_v1.sch, fft_mixer_v1.sch, mixer_sh.sch, pt_fonc_mixer_v1.sch, tb_mixer_v1.sch]
2025-05-28 rectification et bonne sortie du mixer
    [LNA_GC_mixer_v1.sch, LNA_GC_mixer_v1_balun.sch, fft_mixer_v1.sch, mixer_sh.sch, tb_mixer_v1.sch]
2025-05-28 Ajout du balun
    [Balun.sch, mixer_sh.sch, tb_mixer_balun.sch]
2025-05-28 Ajout de balun avec les rectifications et le ng des transistors
    [Balun.sch, mixer_sh.sch, pt_fonc_balun.sch, tb_mixer_balun.sch]
2025-06-03 VCO sr
    [VCOsarah.sch]
2025-06-03 ajout de lna+mixer+balun
    [LNA_GC_mixer_v1.sch, LNA_GC_mixer_v1_balun.sch]
2025-06-03 Essai mixer+vcom
    [LNA_GC_MIXER_v1_VCO_m.sch, LNA_GC_mixer_v1.sch, LNA_GC_mixer_v1_balun.sch, Mixer_v1_VCOm.sch, Symbole_LNA_CG_Diff.sch, VCOsarah.sch, mixer_sh.sch]
2025-06-03 fix balun
    [Balun.sch, pt_fonc_balun.sch]
2025-06-03 Ajout du VCO tim
    [symbol.sch, test bench.sch]
2025-06-03 Ajout de la bonne version du VCO de tim
    [symbol.sch, vco.sch]
2025-06-03 ajout d'un vco qui marche?
    [symbole_VCO.sch]
2025-06-03 modification capa pb drc
    [Balun.sch, mixer_sh.sch, tb_mixer_balun.sch]
2025-06-03 ajout de vco_tim
    [Mixer_v1_VCO_m.sch, Mixer_v1_VCO_t.sch, VCO_tim.sch, mixer_sh.sch]
2025-06-03 Ajout testsymbol du vco...
    [testsymbol.sch]
2025-06-03 TEST AVEC VCO TIM ?
    [Mixer_v1_VCO_t.sch]
2025-06-04 quelques changement et des simu qui marchent
    [Balun.sch, LNA_GC_MIXER_v1_VCO_m.sch, LNA_GC_mixer_v1_VCO_t.sch, LNA_GC_mixer_v1_VCO_t_balun.sch, LNA_GC_mixer_v1_balun.sch, Mixer_v1_VCO_m.sch, Mixer_v1_VCO_t.sch, VCO_tim.sch]
2025-06-04 Modification du miroir de courant
    [Balun.sch, pt_fonc_balun.sch]
2025-06-04 je comprends pas
    [LNA_GC_mixer_v1_balun.sch, fft_mixer_v1.sch, tb_mixer_v1.sch]
2025-06-04 PLL numerique
    [PDC.sch, PFD.sch, PLL.sch, filtre.sch]
2025-06-04 Ajout de la PLL
    [LNA_GC_mixer_v1.sch, Mixer_v1_PLL_m.sch]
2025-06-04 vco 256 sarah
    [VCO_div256_sarah.sch]
2025-06-04 dossier sofian PLLé
    [AND.sch, AND_tb.sch, Bascule_D.sch, Bascule_D_full_MOS.sch, Bascule_D_tb.sch, Charge_Pump.sch, Comparateur_de_phase_tb.sch, INV.sch]
2025-06-05 LNA6deux mixer
    [LNA_GC_deux_mixer.sch, LNA_GC_mixer_v1.sch, Mixer_v1_PLL_m.sch, Mixer_v1_VCO_m.sch, PDC.sch, PFD.sch, PLL.sch, VCO_div256_sarah.sch]
2025-06-05 Ajout de mixer+balun avec pin GND
    [Balun_bounding.sch, Mixer_bounding.sch]
2025-06-05 LNA bounding pour sara(H) la dictatrice
    [Symbole_LNA_CG_Diff_Bounding.sch]
2025-06-05 MAJ Balun
    [tb_balun.sch]
2025-06-06 commencement des simu avec bounding
    [Balun_bounding.sch, Gain_mixer.sch, LNA_GC_deux_mixer_balun.sch, Mixer_bounding.sch, Rx.sch, Symbole_LNA_CG_Diff_Bounding.sch, mixer_sh.sch, tb_Rx.sch]
2025-06-11 dernière touche
    [LNA_GC_deux_mixer_balun.sch, tb_Rx.sch, tb_Rx_bounding.sch, tb_Rx_sans_bounding.sch]
2025-06-11 PLL verilog-a dossier final
    [FDIV.sch, FDIV256.sch, FDIV256_test.sch, FDIV4.sch, FDIV8.sch, PDC.sch, PDC.va.cfg, PDC_test.sch]
2025-06-11 nettoyage dossier Verilog-a
    [PLL.sch, VCO_FDIV_test.sch]
2025-06-11 Bench propre LNA pour la branche main
    [Bench_LNA_CG_Diff_AvecReseau.sch, Bench_LNA_CG_Diff_IIP3.sch, Bench_LNA_CG_Diff_SansReseau.sch, Bench_LNA_CG_Diff_Stabilité.sch, Bench_LNA_CG_Diff_Tran.sch, Bench_LNA_CG_Single_AvecReseau.sch, Bench_LNA_CG_Single_SansReseau.sch, Bench_LNA_CG_Single_Trans.sch]
2025-06-11 MAj des bench main : symbole LNA single et reseau d'adapt
    [Symbole_LNA_CG_Single.sch]
2025-06-11 Version propre du dossier diviseur de frequence et du chaînage de la PLL analogique
    [DIV_PAR_256_VF.sch, Diviseur_par_2-digital_symbole.sch, Diviseur_par_2-digital_symbole_test.sch, Diviseur_par_2_sinusoidale_symbole.sch, Diviseur_par_2_sinusoidale_symbole_testbench.sch, PLL_ANALOG_Total.sch, TEST_256_definitif.sch]
2025-06-11 Ajout des dossier dimensionnement et LNA depuis dev
    [LNA_Bench_Parametre_S.sch, LNA_Bench_Parametre_S_NF.sch, LNA_Bench_Parametre_S_non_adapt.sch, LNA_Bench_Transitoire.sch, LNA_non_adapt_sym.sch, LNA_sym.sch, LNA_xschem.sch, S11.csv]
2025-06-11 clean folder LNA_Ind_degen
    [LNA_diff.sch, LNA_single.sch, Simu_LNA_Single.sch, Simu_LNA_diff.sch, reseau_adaptation_out.sch]
2025-06-11 ajout model inductance 1.6nH
    [Extraction_modele_IND_1P_1.6nH.sch, Modele_Inductance_1.6nH.sch, Modele_Performance.sch]
2025-06-11 LNA Inductance Degen - dimensionnement - finale push
    [LNA_sym.sch, S11.csv, S12.csv, S21.csv, S22.csv]
2025-06-11 ajout netlist
    [LNA_xschem.sch]
2025-06-12 ajout image bench transitoire
    [nmos.sch, test_inductance.sch, test_resistance.sch]
2025-06-12 Sofian qui arrive en legende avec sa pompe de charge
    [INV_1X.sch]
2025-06-12 ajout VCO
    [Extrac_gm.sch, Paire croisee.sch, VCO_Symbol_Cdec.sch, caracL.sch, tank_vco.sch, test_vco_wirebounding.sch, vco.sch]
2025-06-13 ajout dossier developpement et documentation
    [AND.sch, AND_tb.sch, Balun.sch, Balun_bounding.sch, Bascule_D.sch, Bascule_D_full_MOS.sch, Bascule_D_tb.sch, Bench_LNA_CG_Diff_AvecReseau.sch]
2025-06-13 ajout AgriZigbee
    [Model_de_consommation_v0.xlsx]
2025-06-13 Rename documentation/design/These_Salimy_Final_BU_sans_annexes_confidentielles (glissés).pdf to documentation/design/Inductance/These_Salimy_Final_BU_sans_annexes_confidentielles (glissés).pdf
